HuTongShan/-_-_PLC/SH2024-0302-018/产前文件/SH2024-0302-018电气原件采购.xlsx

版权保护。严令禁止在未获得明确授权的情况下转发和复制本文档，利用及传播其内容。 | 0 |  |  |  |  | 1 |  | 2 |  | 3 |  |  | 4 |  |  | 5 |  | 6 |  |  |  | 7 |  | 8 |  |  | 9
 | 部件汇总表
 |  | 序号 |  | 标识符 |  |  |  |  | 名称 |  | 规格型号 |  |  |  | 技术参数 |  |  |  | 数量 |  | 单位 |  | 品牌 |  | 备注
 |  | 2 |  | F1 |  |  |  |  | IC65N断路器 |  | SE.A9F19440 |  |  |  | 4P D40A |  |  |  | 1 |  | 件 |  | 施耐德 |  | 断路器
 |  | 3 |  | F2 |  |  |  |  | IC65N断路器 |  | SE.A9F19320 |  |  |  | 3P D20A |  |  |  | 1 |  | 件 |  | 施耐德 |  | 断路器
 |  | 4 |  | F3 |  |  |  |  | IC65N断路器 |  | SE.A9F19210 |  |  |  | 2P D10A |  |  |  | 1 |  | 件 |  | 施耐德 |  | 断路器
 |  | 5 |  | F4 |  |  |  |  | IC65N断路器 |  | SE.A9F19206 |  |  |  | 2P D6A |  |  |  | 1 |  | 件 |  | 施耐德 |  | 断路器
 |  | 6 |  | P2 |  |  |  |  | 蜂鸣器 |  | XB2BSB4LC |  |  |  | 24V红/带灯 |  |  |  | 1 |  | 个 |  | 施耐德 |  | 开孔尺寸(mm)Φ22
 |  | 7 |  | P5 |  |  |  |  | 触摸屏 |  | 6AV66480DC113AX0 |  |  |  | SMART 700 IE V4 |  |  |  | 1 |  | 个 |  | 西门子
 |  | 8 |  | PLC-AI |  |  |  |  | 模拟量输出模块 |  | SIE.6ES7288-3AE04-0AA0 |  |  |  |  |  |  |  | 1 |  | 件 |  | 西门子
 |  | 9 |  | PLC-CPU |  |  |  |  | PLC |  | SIE.6ES7288-1SR30-0AA0 |  |  |  |  |  |  |  | 1 |  | 件 |  | 西门子
 |  | 10 |  | PLC-com |  |  |  |  | PLC扩展板 |  | SIE.6ES7288-5CM01-0AA0 |  |  |  |  |  |  |  | 1 |  | 件 |  | 西门子
 |  | 11 |  | XT1 |  |  |  |  | 插座 |  | CHT.AC30 5P10A |  |  |  | 10A |  |  |  | 1 |  | 个 |  | 正泰 |  | 模数化五孔插座
 |  | 12 |  | U1 |  |  |  |  | 变频器 |  | IC863-AVT-0150-403-20 |  |  |  | 11KW |  |  |  | 1 |  | 台 |  | 艾默生 |  | IP21防护等级
 |  | 13 |  | KM1 |  |  |  |  | LC1D接触器 |  | SE.LC1D09M7C |  |  |  | 09A 220VAC |  |  |  | 1 |  | 件 |  | 施耐德
 |  | 14 |  | KM2 |  |  |  |  | LC1D接触器 |  | SE.LC1D18M7C |  |  |  | 18A 220VAC |  |  |  | 1 |  | 件 |  | 施耐德
 |  | 15 |  | Q1 |  |  |  |  | GV2PM电机断路器 |  | SE.GV2PM05C |  |  |  | 0.63-1 A |  |  |  | 1 |  | 件 |  | 施耐德 |  | TeSys GV2P - 3P - 0.63...1 A
 |  | 16 |  | Q2 |  |  |  |  | GV3P电机断路器 |  | SE.GV3P18 |  |  |  | 12-18 A |  |  |  | 1 |  | 件 |  | 施耐德 |  | TeSys GV3P - 3P - 12...18A - EverLink BTR接触
 |  | 17 |  | A3 |  |  |  |  | 交换机 |  | TL-SF1005工业级 |  |  |  | TL-SF1005工业级 |  |  |  | 1 |  | 个 |  | TP-LINK |  | 5个10/100MRJ45口
 |  | 18 |  | P3 |  |  |  |  | 指示灯 |  | XB2BVB3LC |  |  |  | DC24V绿 |  |  |  | 1 |  | 个 |  | 施耐德 |  | 开孔尺寸(mm)Φ22
 |  | 19 |  | P4 |  |  |  |  | 指示灯 |  | XB2BVB4LC |  |  |  | DC24V红 |  |  |  | 1 |  | 个 |  | 施耐德 |  | 开孔尺寸(mm)Φ22
 |  | 20 |  | F5 |  |  |  |  | 急停按钮 |  | XB2BS545C |  |  |  | 红色1NO+1NC |  |  |  | 1 |  | 个 |  | 施耐德 |  | 开孔:Φ22，按钮头:Φ40
 |  | 21 |  | KA1;KA2 |  |  |  |  | 继电器 |  | SE.RXM4LB2BD+RXZE1M4C |  |  |  | DC 24V |  |  |  | 2 |  | 件 SE- |  | RXM RSL继电 |  | 器
 |  | 22 |  | S1;S2 |  |  |  |  | 旋转开关 |  | XB2BD21C |  |  |  | 1NO |  |  |  | 2 |  | 个 |  | 施耐德 |  | 开孔尺寸(mm)Φ22
 |  | 23 |  | S3 |  |  |  |  | 平头复位按钮 |  | XB2BA51C |  |  |  | 黄 1NO |  |  |  | 1 |  | 个 |  | 施耐德 |  | 开孔尺寸(mm)Φ22
 |  | 24 |  | S4 |  |  |  |  | 平头复位按钮 |  | XB2BA31C |  |  |  | 绿 1NO |  |  |  | 1 |  | 个 |  | 施耐德 |  | 开孔尺寸(mm)Φ22
 |  | 25 |  | S5 |  |  |  |  | 平头复位按钮 |  | XB2BA42C |  |  |  | 红 1NC |  |  |  | 1 |  | 个 |  | 施耐德 |  | 开孔尺寸(mm)Φ22
 |  | 26 |  | T1 |  |  |  |  | EDR电源 |  | MW.EDR-75-24 |  |  |  | 3.2A |  |  |  | 1 |  | 个 |  | MW
 | &EAA/16 2
 |  |  |  |  |  |  | 项目名称 SH2024-0302-018 |  |  |  |  | 项目编号 SH2024-0302-018 |  | 冉昆真空科技（浙江）有限公司 |  |  | 部件汇总表 : - MW.EDR-75-24 |  |  |  |  |  |  |  |  | = |  | &EAB
 |  |  |  |  |  |  | SH2024-0302-018电气设计
 |  |  |  |  |  |  |  |  |  |  |  | 图号 |  |  |  |  |  |  |  |  |  |  |  |  |  | + |  | 页 1
修改 |  |  | 日期 |  | 姓名 |  | 创建者 虎存ft |  |  |  |  | 批准人 |  |  |  |  | 日期 2024/3/15 |  |  | 校对 虎存ft |  |  |  |  |  |  |  | 页数 17 从 20
