HuTongShan/-_-_PLC/SH2024-0302-018/产前文件/挂墙孔.dxf

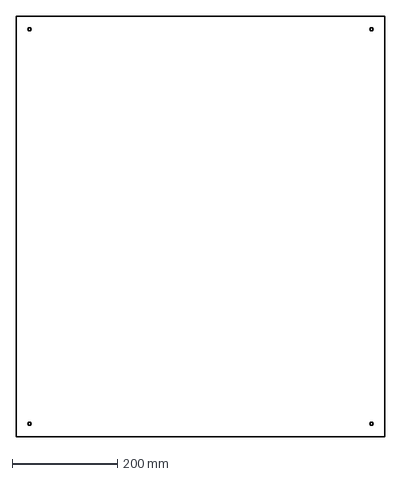
[picture p1: CAD file, 2025-05-08]
SH2024-0302-018/产前文件/挂墙孔.dxf
700.0 x 800.0 mm
