HuTongShan/-_-_PLC/SH2024-0302-018/产前文件/SH2024-0302-018电气原理图.pdf

页数 | 从

## SH2024-0302-018电气设计

校对

SH2024-0302-018

日期 | 日期 | EPL
修改
3 | 6 | 7 | 8 | 9
2021/3/30 | 1
姓名
冉昆真空科技（浙江）有限公司 | &EAA

+

首页 | =
页 | 1
批准人

项目名称

图号

项目编号

创建者 | 虎存山

版权保护。严令禁止在未获得明确授权的情况下转发和复制本文档，利用及传播其内容。

# 冉昆真空科技（浙江）有限公司

项目描述 | SH2024-0302-018电气设计

页数

设计

# 编辑日期：

图号 | SH2024-0302-018

20

# 浙江嘉兴

# 虎存山

地址

# 制造商(公司)

项目名称 | SH2024-0302-018
项目负责人 | 王经理

# 公司/客户

2024/3/15 | 创建者：

# 冉昆真空科技（浙江）有限公司

电话 | +49 (0)2173 - 39 64 - 0

# 审核人：王经理

# 冉昆真空科技（浙江）有限公司

页数

从

日期 | 日期 | 虎存山 1

2024/3/14

冉昆真空科技（浙江）有限公司 | &EAA +

## 目录 : &EAA/1 - &EAB/2.a

=

页

版权保护。严令禁止在未获得明确授权的情况下转发和复制本文档，利用及传播其内容。

页码 | | | | | | 页描述 | | | | | | | | | | | | | | | | | | | | | | | | | | | | | | 编辑者

目录

页类型 | 日期
1 | 标题页/封页 | 首页 | 2021/3/30 | EPL 2 | 目录 | 目录 : &EAA/1 - &EAB/2.a | 2024/3/14 | 虎存山 3 | 安装板布局 | 机柜三视图 | 2024/3/14 | 虎存山 4 | 安装板布局 | 机柜安装板 | 2024/3/14 | 虎存山 5 | 多线原理图 | 主回路 | 2024/3/14 | 虎存山 6 | 多线原理图 | 风扇&插座 | 2024/3/14 | 虎存山 7 | 多线原理图 | 变频器 | 2024/3/14 | 虎存山 8 | 多线原理图 | PLC-CPU | 2024/3/14 | 虎存山 9 | 多线原理图 | PLC-AI/COM | 2024/3/14 | 虎存山
10 | 多线原理图 | 柜内-DI | 2024/3/14 | 虎存山
11 | 多线原理图 | 柜外-DI | 2024/3/14 | 虎存山
12 | 多线原理图 | 柜内-DQ | 2024/3/14 | 虎存山
13 | 多线原理图 | 柜外-DQ | 2024/3/14 | 虎存山
14 | 多线原理图 | 信号处理 | 2024/3/14 | 虎存山
15 | 多线原理图 | AI接线 | 2024/3/14 | 虎存山
16 | 多线原理图 | 通讯界面 | 2024/3/14 | 虎存山
17 | 部件汇总表 | 部件汇总表 : - MW.EDR-75-24 | 2024/3/14 | 虎存山
18 | PLC 地址概览 | | 2024/3/14 | 虎存山
19 | PLC 地址概览 | | 2024/3/14 | 虎存山

700 mm

192 mm

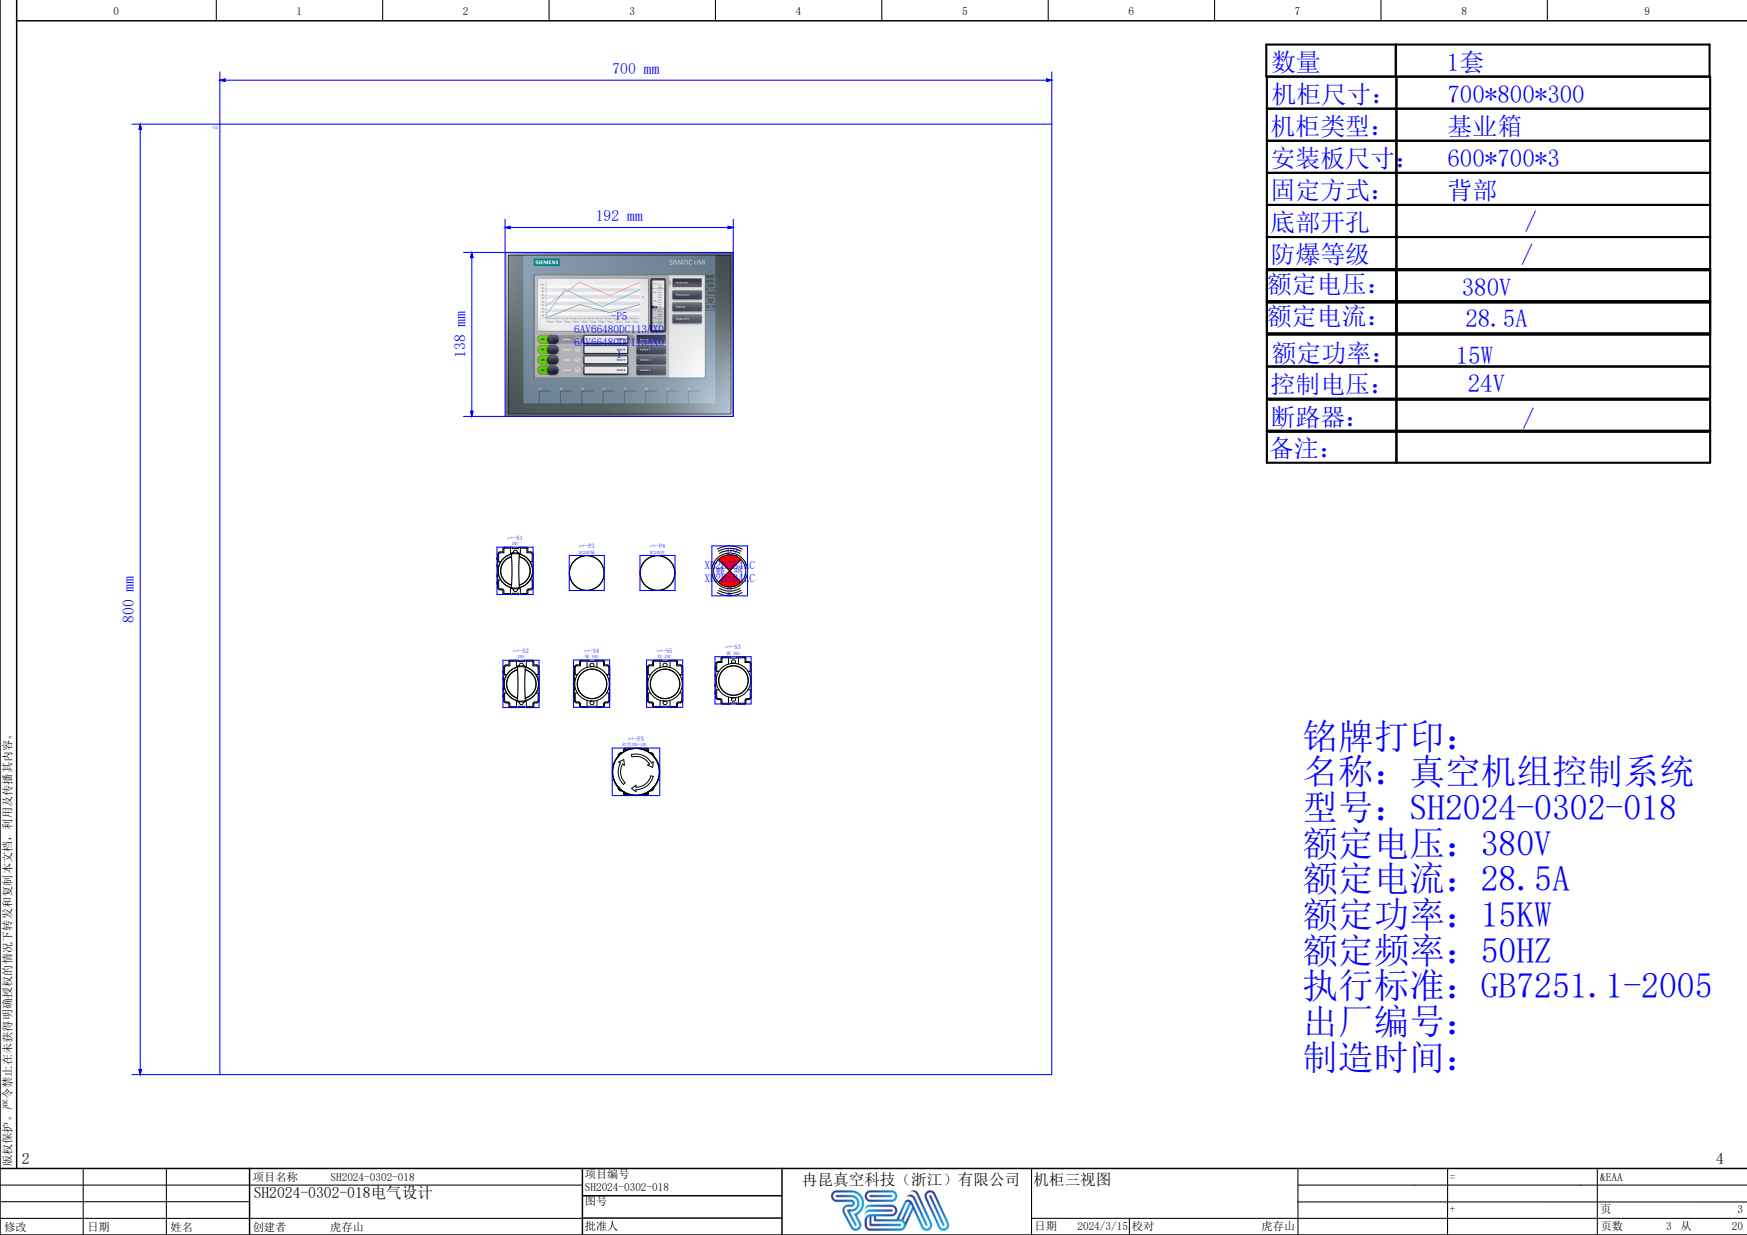
[picture p2: page 3]
虎存山 1; 冉昆真空科技（浙江）有限公司; &EAA +; 机柜三视图; -P2 XB2BSB4LC XB2BSB4LC 2; 铭牌打印： 名称：真空机组控制系统 型号：SH2024-0302-018 额定电压：380V 额定电流：28.5A 额定功率：15KW 额定频率：50HZ 执行标准：GB7251.1-2005 出厂编号： 制造时间：

数量 | 1套
机柜尺寸： | 700*800*300
机柜类型： | 基业箱
安装板尺寸： 600*700*3
固定方式： | 背部
底部开孔 | //
防爆等级
额定电压： | 380V
额定电流： | 28.5A
额定功率： | 15W
控制电压： | 24V
断路器： | /
备注：

版权保护。严令禁止在未获得明确授权的情况下转发和复制本文档，利用及传播其内容。

# AC30 5P10A 9DC 24V =+-KA1

600 mm

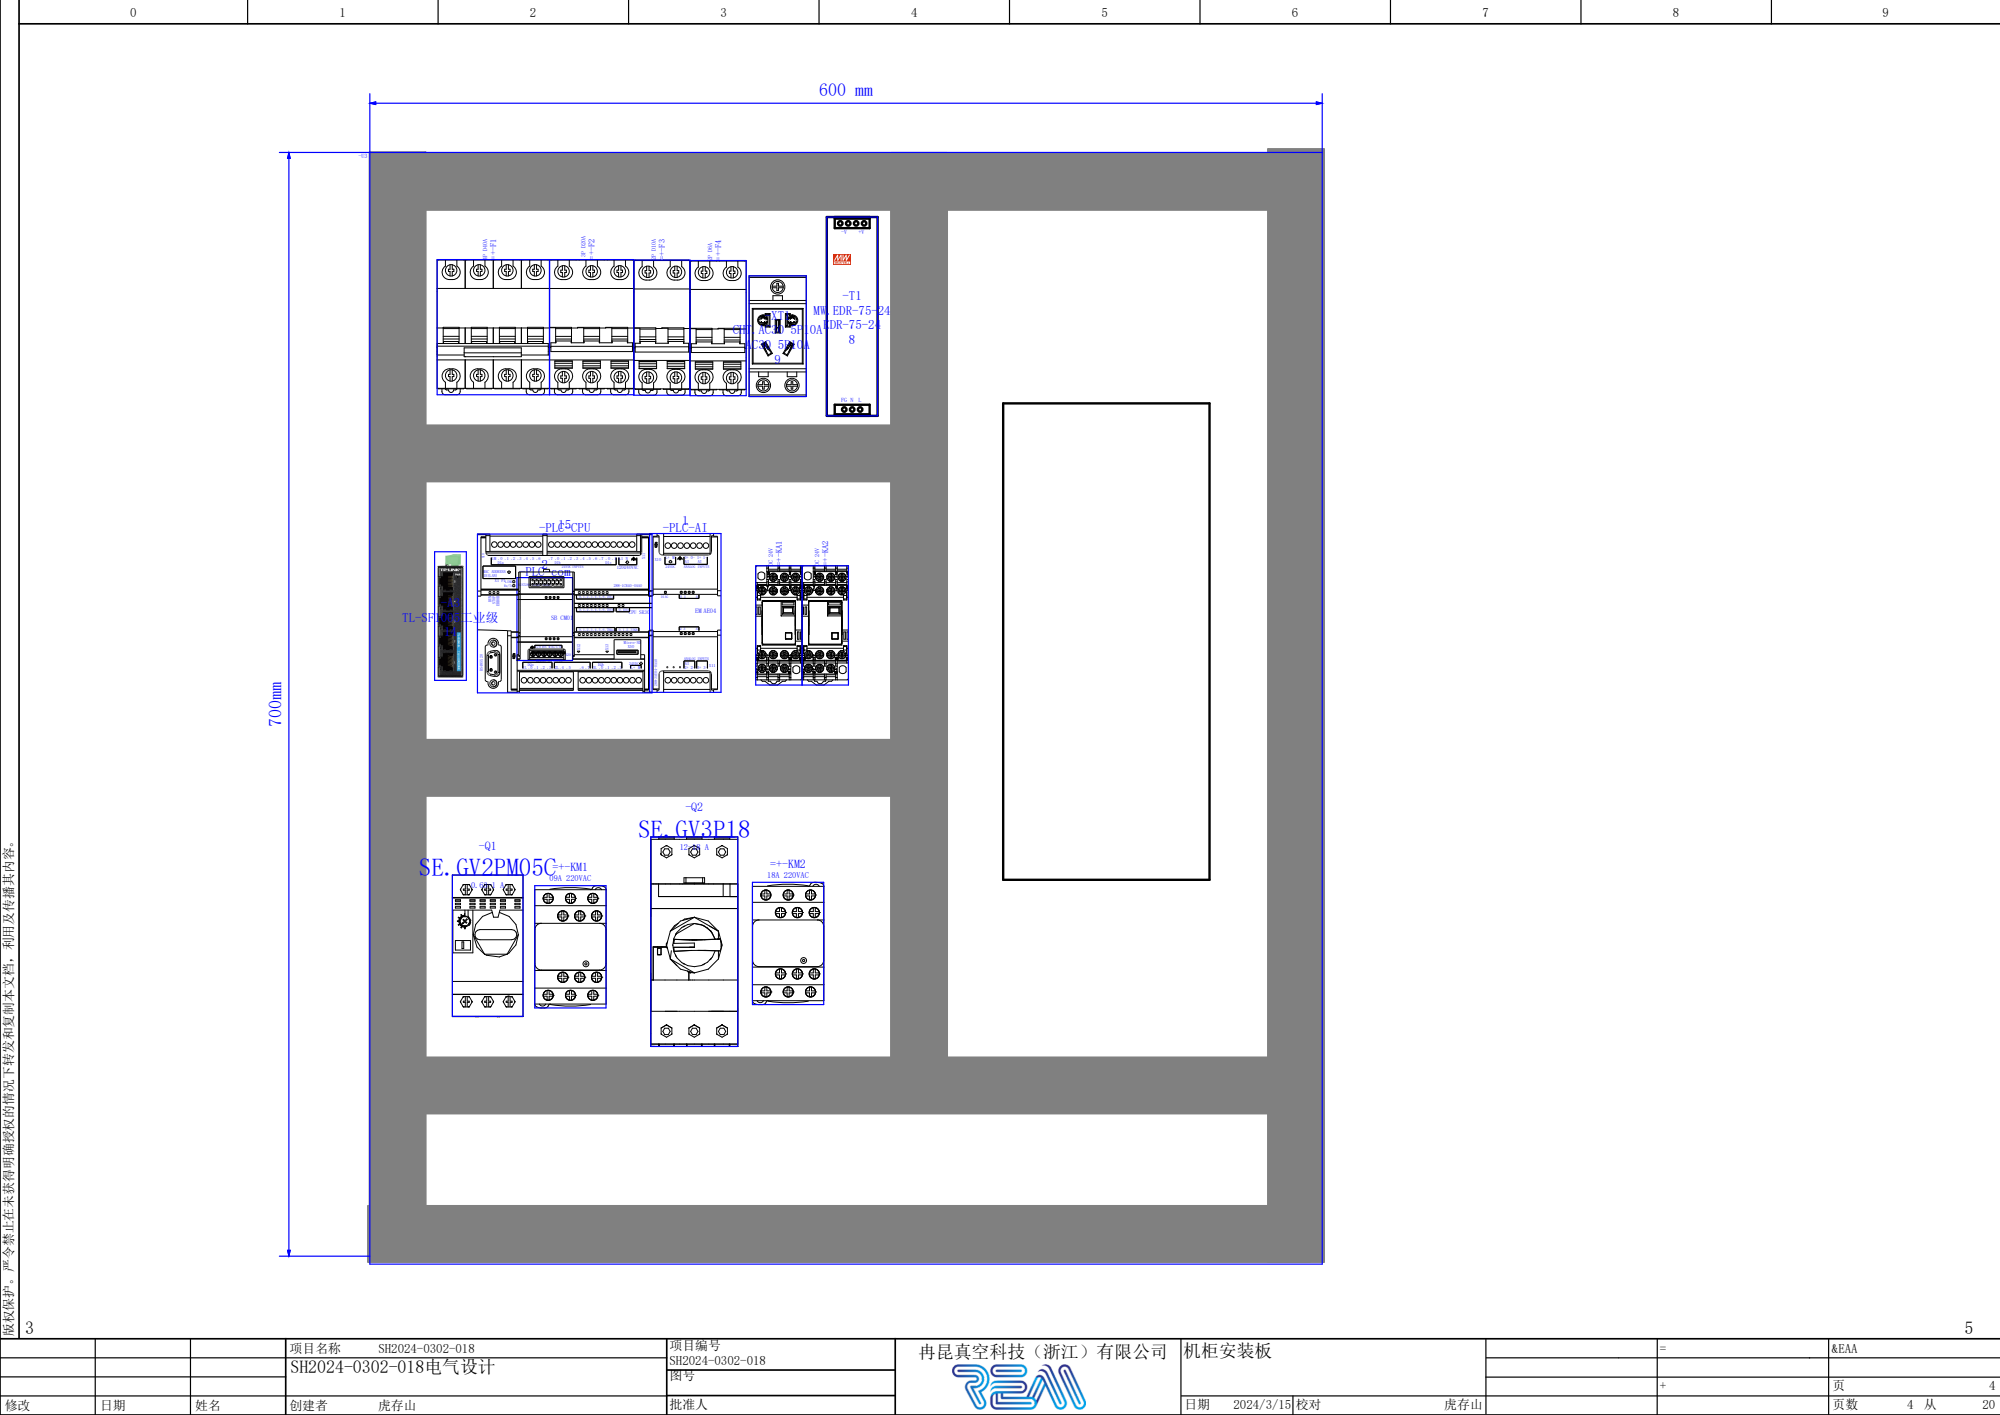
[picture p3: page 4]
虎存山 1; 冉昆真空科技（浙江）有限公司; &EAA +; 机柜安装板; DIAG; ANALOG INPUTS; VDC; ANALOG INPUTS 1 -PLC-AI; Tx/B RTS; 2 -PLC-com; -T1 MW.EDR-75-24 EDR-75-24 8; -XT1 CHT.AC30 5P10A; 09A 220VAC; 18A 220VAC; -A3 TL-SF1005工业级 14; DIa; Micro-SD; STOP ERROR; DQa; CPU SR30; LINK; RELAY OUTPUTS; INPUTS; -240VAC; DIb; .0.1.2.3.4.5.6.7DIb .0.1DIc; .0.1.2.3DQb X12; DQb; 24VDC; .0 .1 DIc; -PLC-CPU 15

MAC ADDRESS
IE(LAN) RUN

版权保护。严令禁止在未获得明确授权的情况下转发和复制本文档，利用及传播其内容。

-F1

L1 /

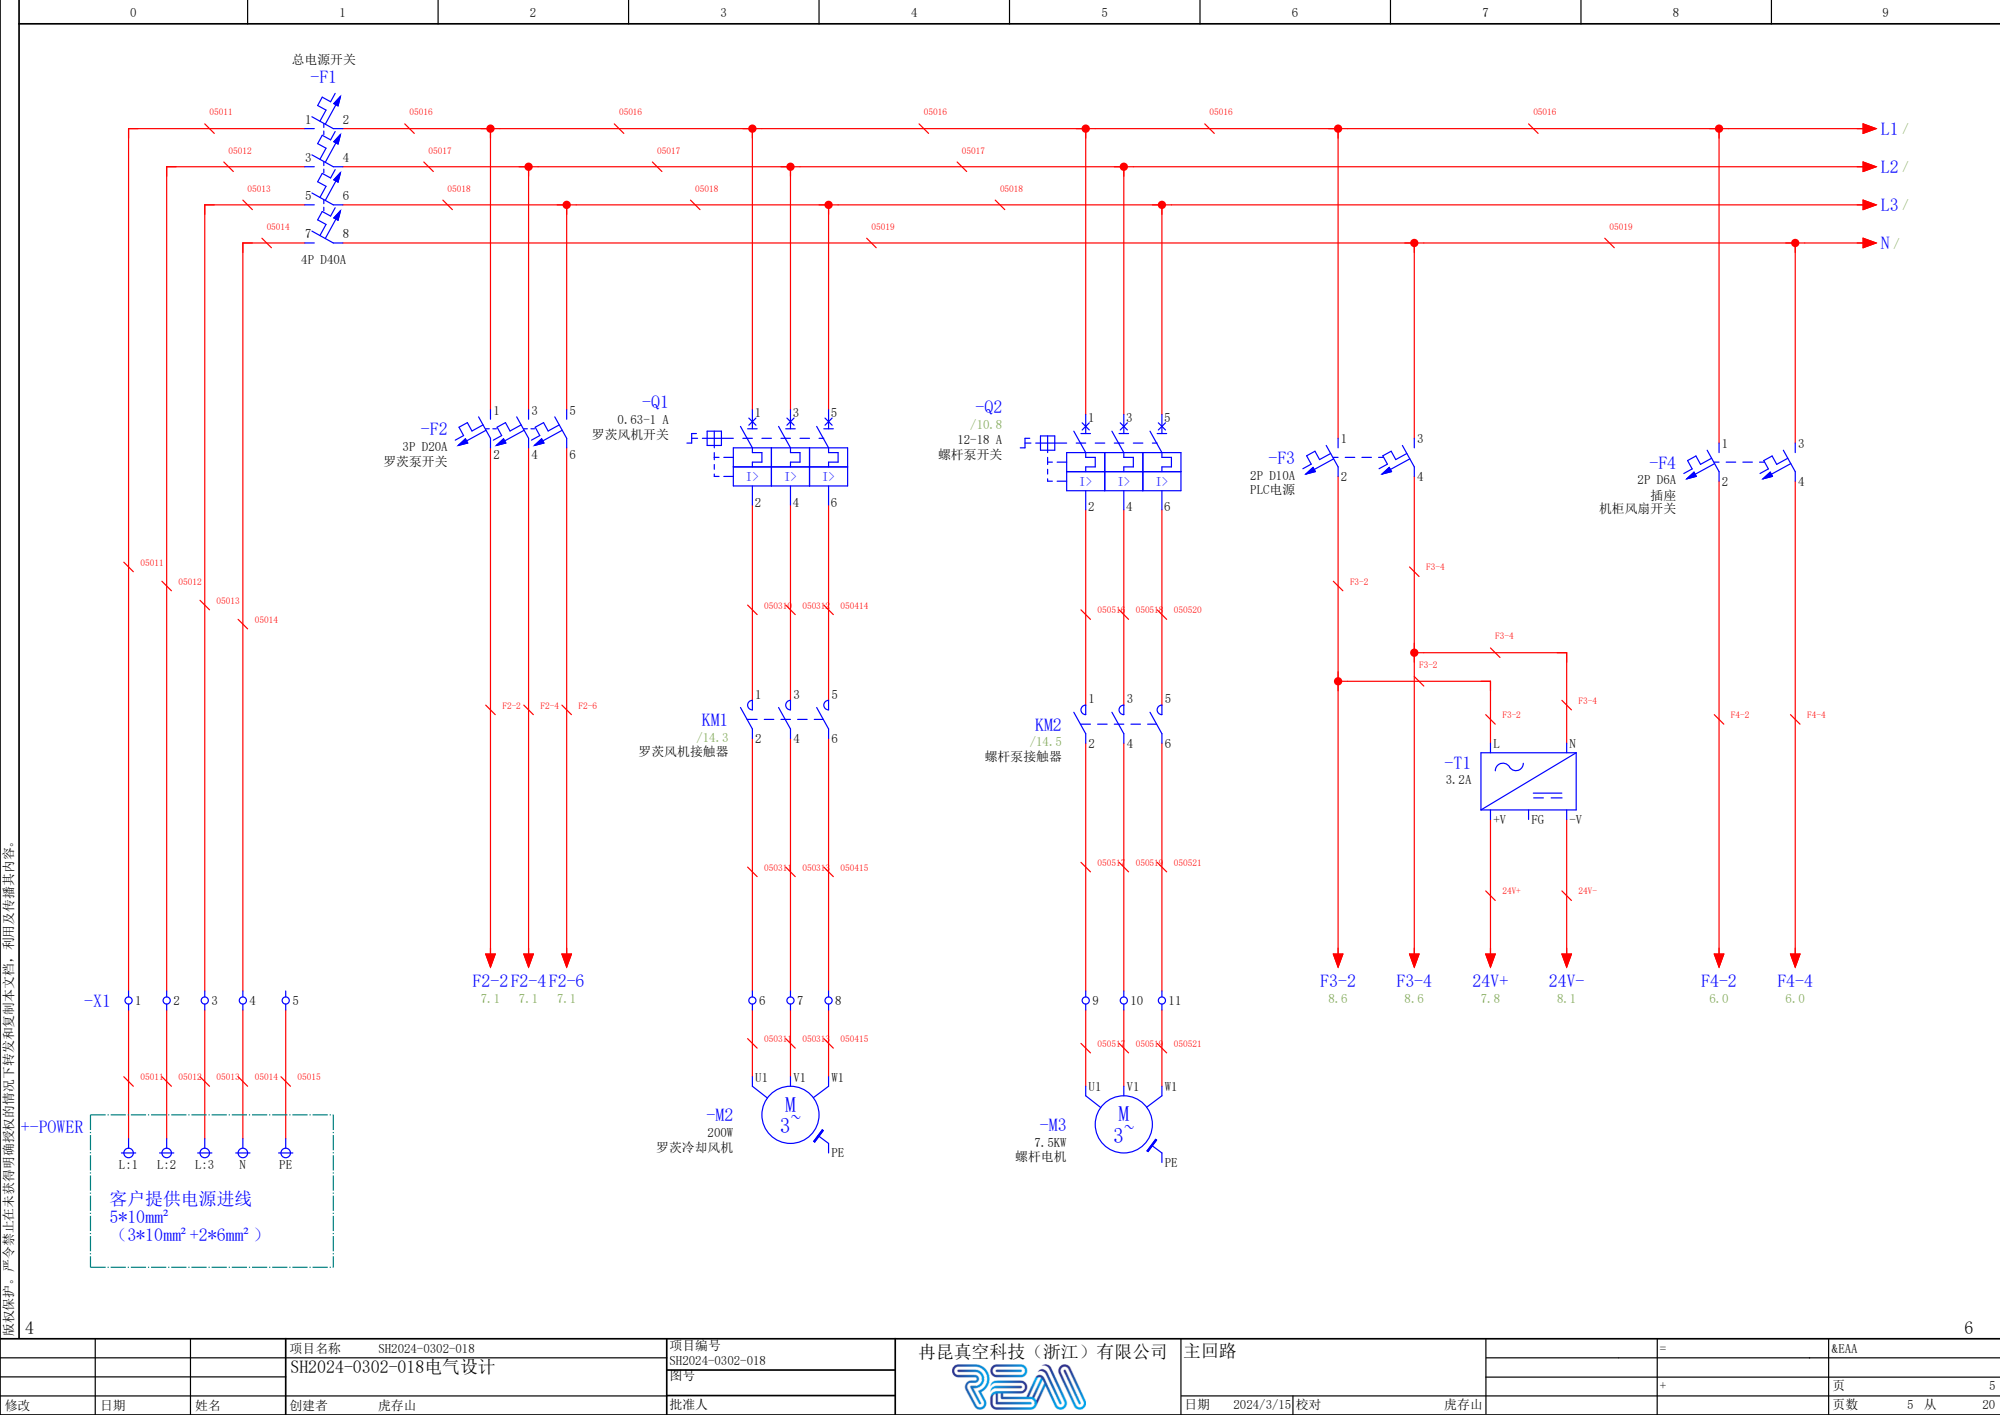
[picture p4: page 5]
虎存山; 主回路; 客户提供电源进线 5*10mm² （3*10mm²+2*6mm²）; 0.63-1 A 罗茨风机开关; /10.8 12-18 A 螺杆泵开关; +-POWER; 200W 罗茨冷却风机; 7.5KW 螺杆电机; 总电源开关; 3P D20A 罗茨泵开关; 2P D10A PLC电源; 2P D6A 插座 机柜风扇开关; /14.3 罗茨风机接触器; /14.5 螺杆泵接触器

版权保护。严令禁止在未获得明确授权的情况下转发和复制本文档，利用及传播其内容。

F4-2 / 5.8

F4-4 / 5.9

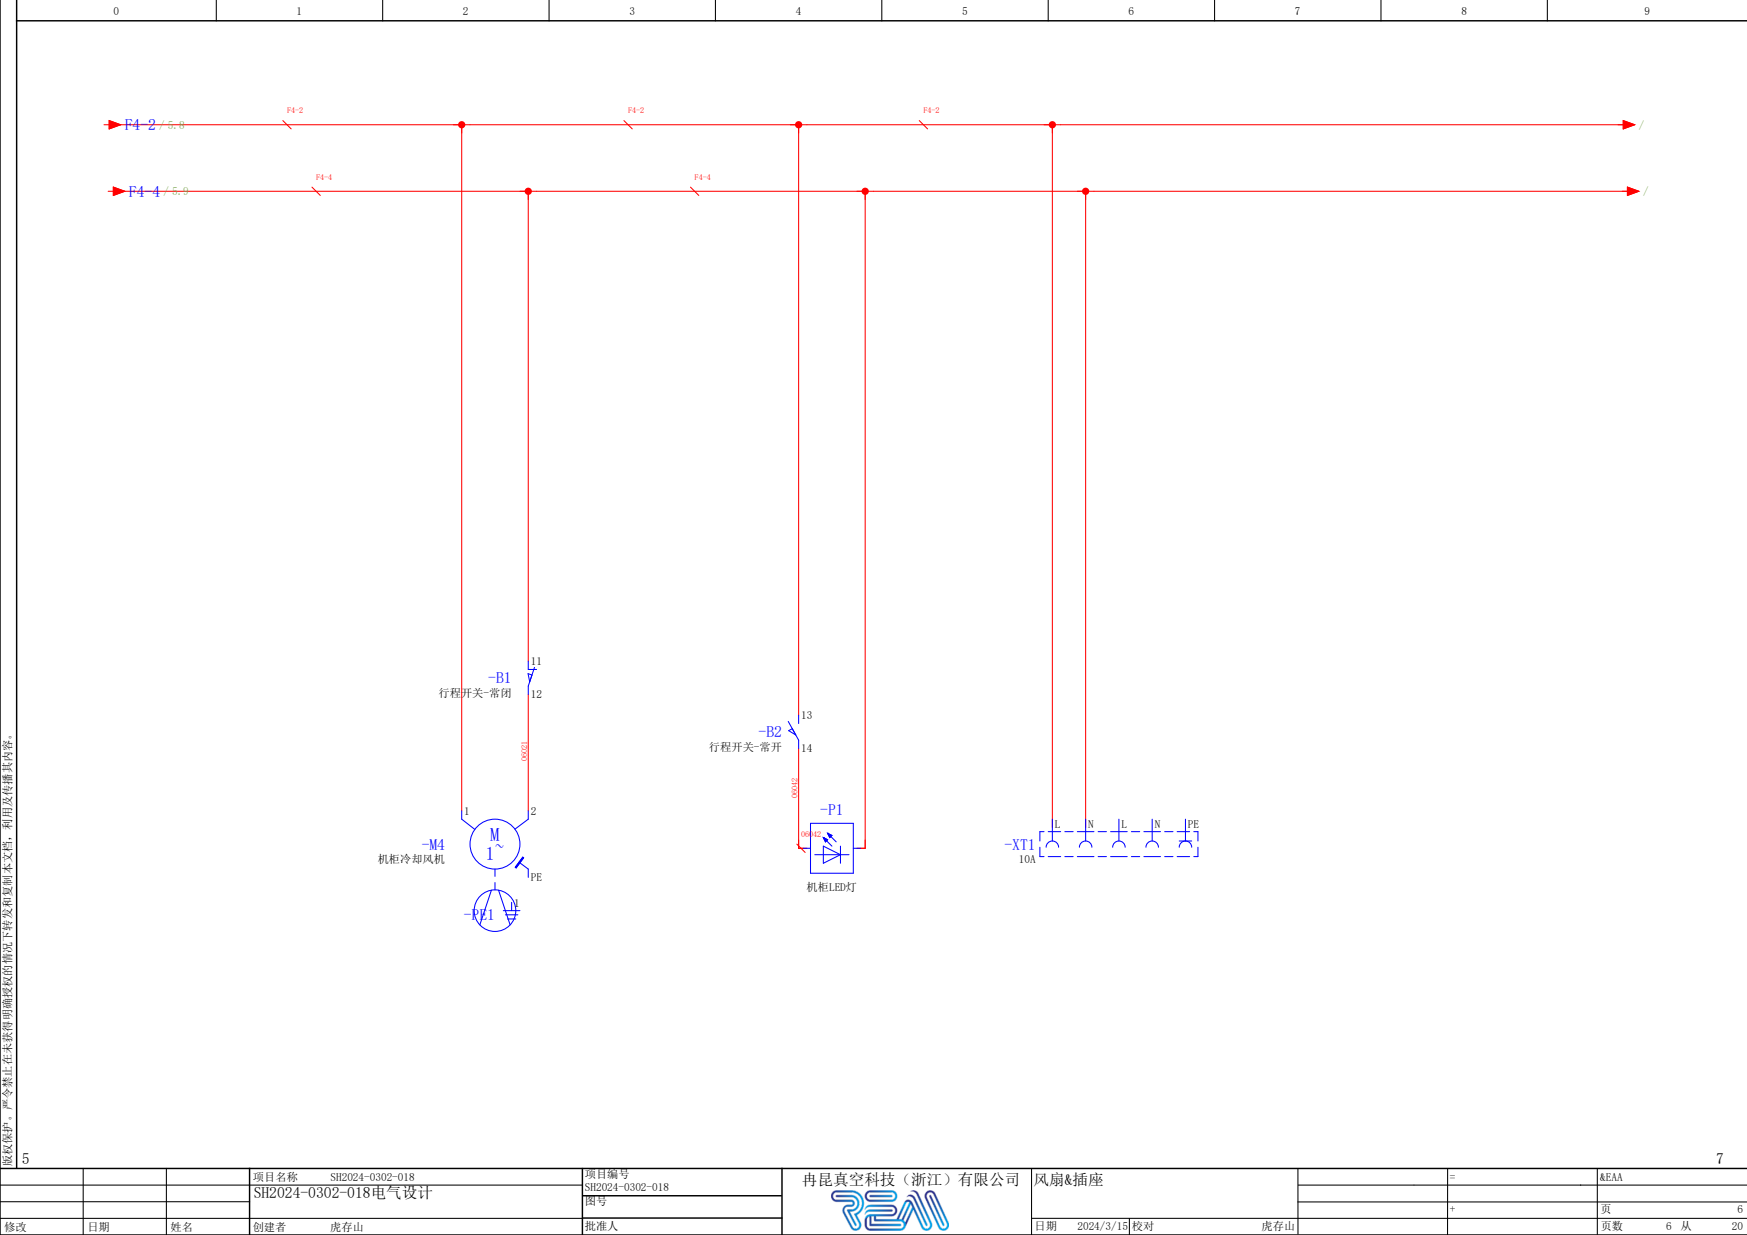
[picture p5: page 6]
机柜冷却风机; 机柜LED灯; 行程开关-常闭; 行程开关-常开

版权保护。严令禁止在未获得明确授权的情况下转发和复制本文档，利用及传播其内容。

-U1

10

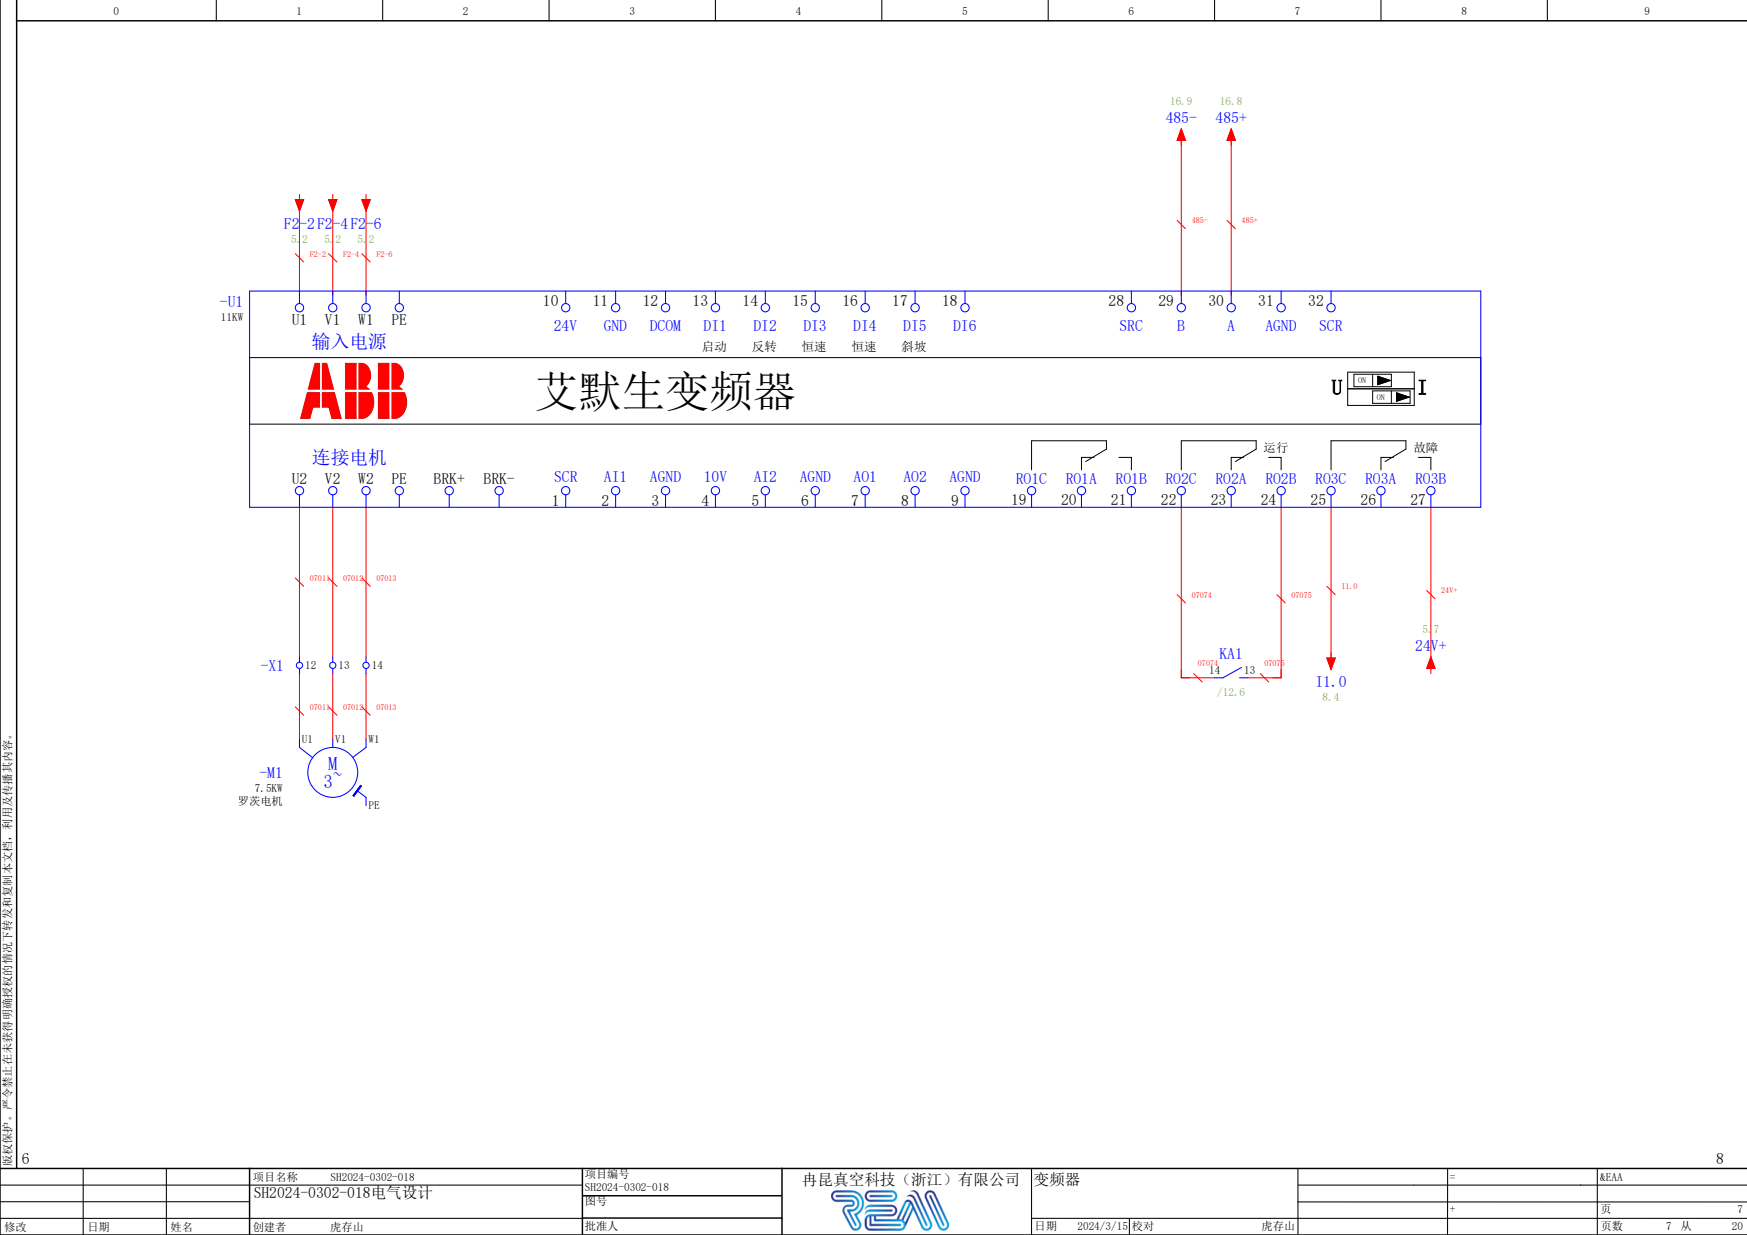
[picture p6: page 7]
变频器; 艾默生变频器; 连接电机; 输入电源; GND; DCOM; BRK+; BRK-; SCR; AGND; SRC; 7.5KW 罗茨电机

版权保护。严令禁止在未获得明确授权的情况下转发和复制本文档，利用及传播其内容。

I0.0
I0.1

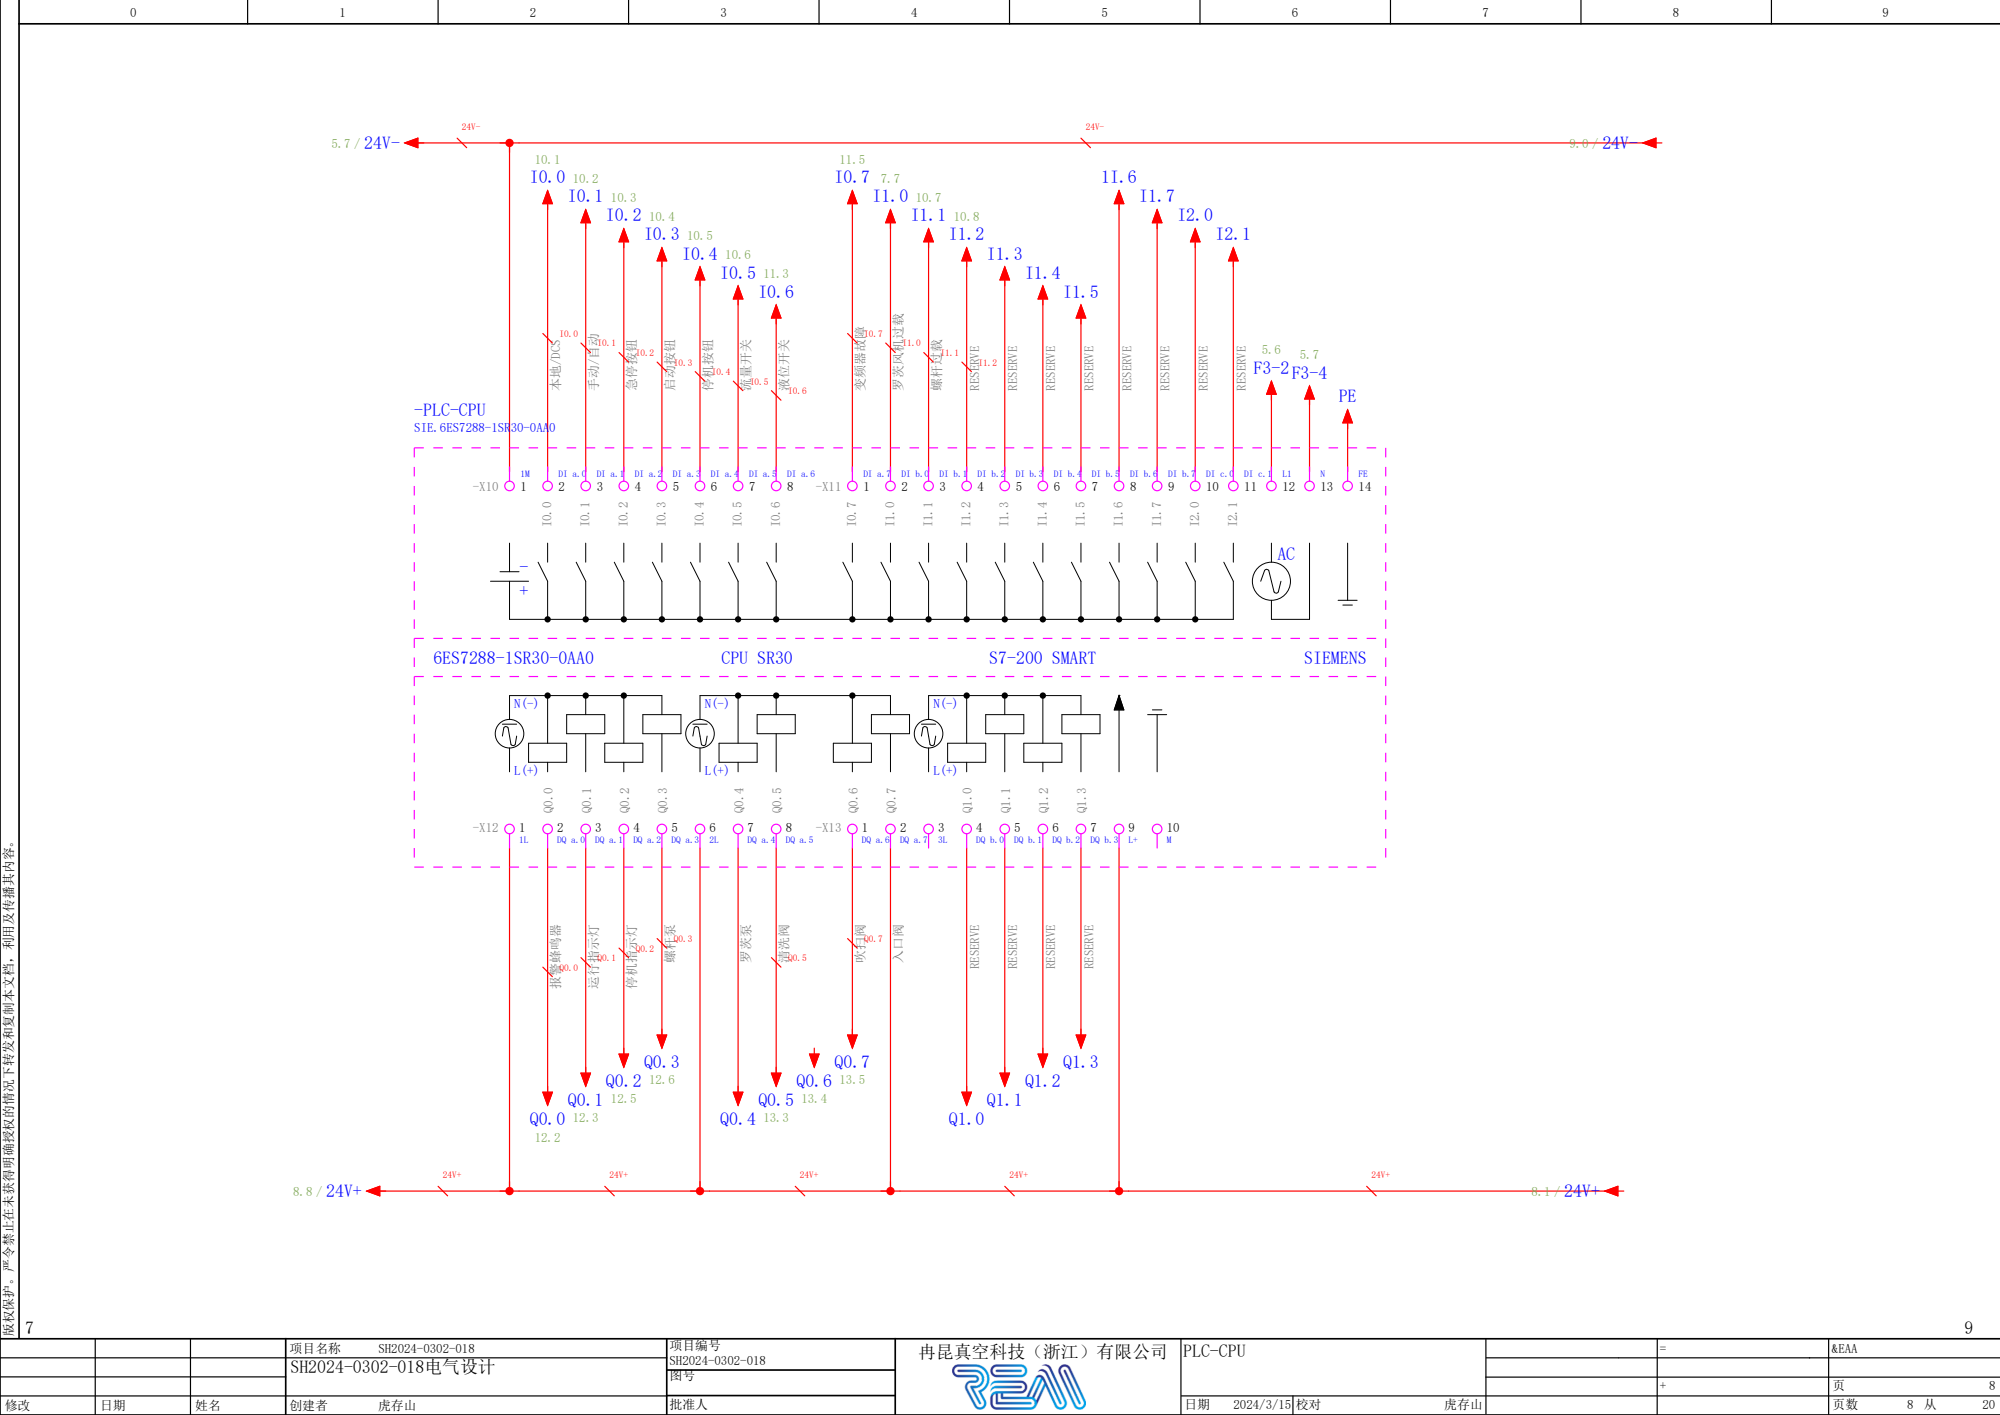
[picture p7: page 8]
PLC-CPU; SIE.6ES7288-1SR30-0AA0; -PLC-CPU; CPU SR30; S7-200 SMART; SIEMENS; I0.0 本地/DCS; I0.2 急停按钮; I0.3 启动按钮; I0.4 停机按钮; I0.5 流量开关; I0.6 液位开关; I0.7 变频器故障; I1.0 罗茨风机过载; I1.1 螺杆过载; I1.2 RESERVE; I1.3 RESERVE; I1.4 RESERVE; I1.5 RESERVE; I1.6 RESERVE; I1.7 RESERVE; I2.0 RESERVE; I2.1 RESERVE; Q0.0 报警蜂鸣器; Q0.1 运行指示灯; Q0.2 停机指示灯; Q0.3 螺杆泵; Q0.5 清洗阀; Q0.4 罗茨泵; Q0.7 入口阀; Q0.6 吹扫阀; Q1.0 RESERVE; Q1.1 RESERVE; Q1.3 RESERVE; Q1.2 RESERVE

版权保护。严令禁止在未获得明确授权的情况下转发和复制本文档，利用及传播其内容。

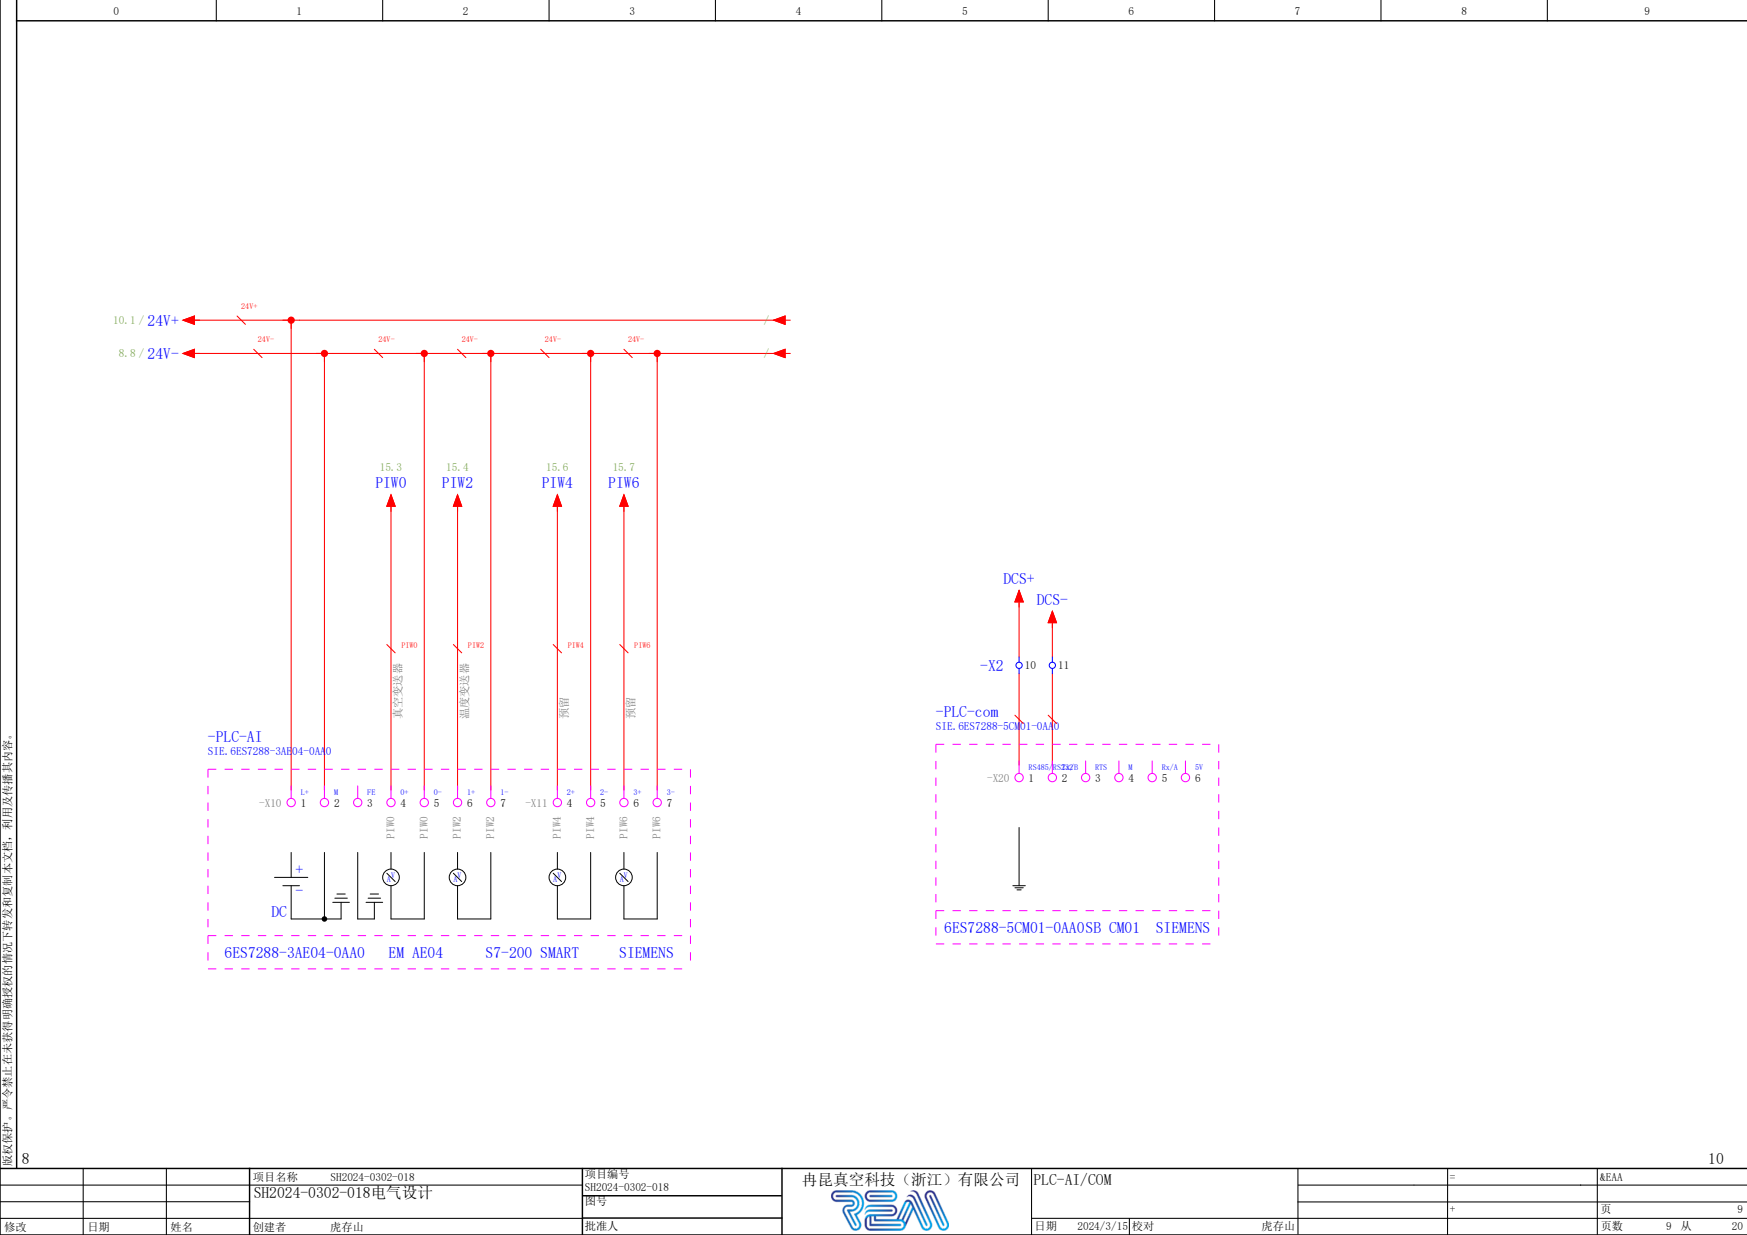
[picture p8: page 9]
PLC-AI/COM; SIE.6ES7288-3AE04-0AA0; -PLC-AI; S7-200 SMART; SIEMENS; PIW0 真空变送器; PIW0; PIW2 温度变送器; PIW2; PIW4 预留; PIW4; PIW6 预留; PIW6; SIE.6ES7288-5CM01-0AA0; -PLC-com; 6ES7288-5CM01-0AA0SB CM01 SIEMENS; RTS; DCS+; DCS-

版权保护。严令禁止在未获得明确授权的情况下转发和复制本文档，利用及传播其内容。

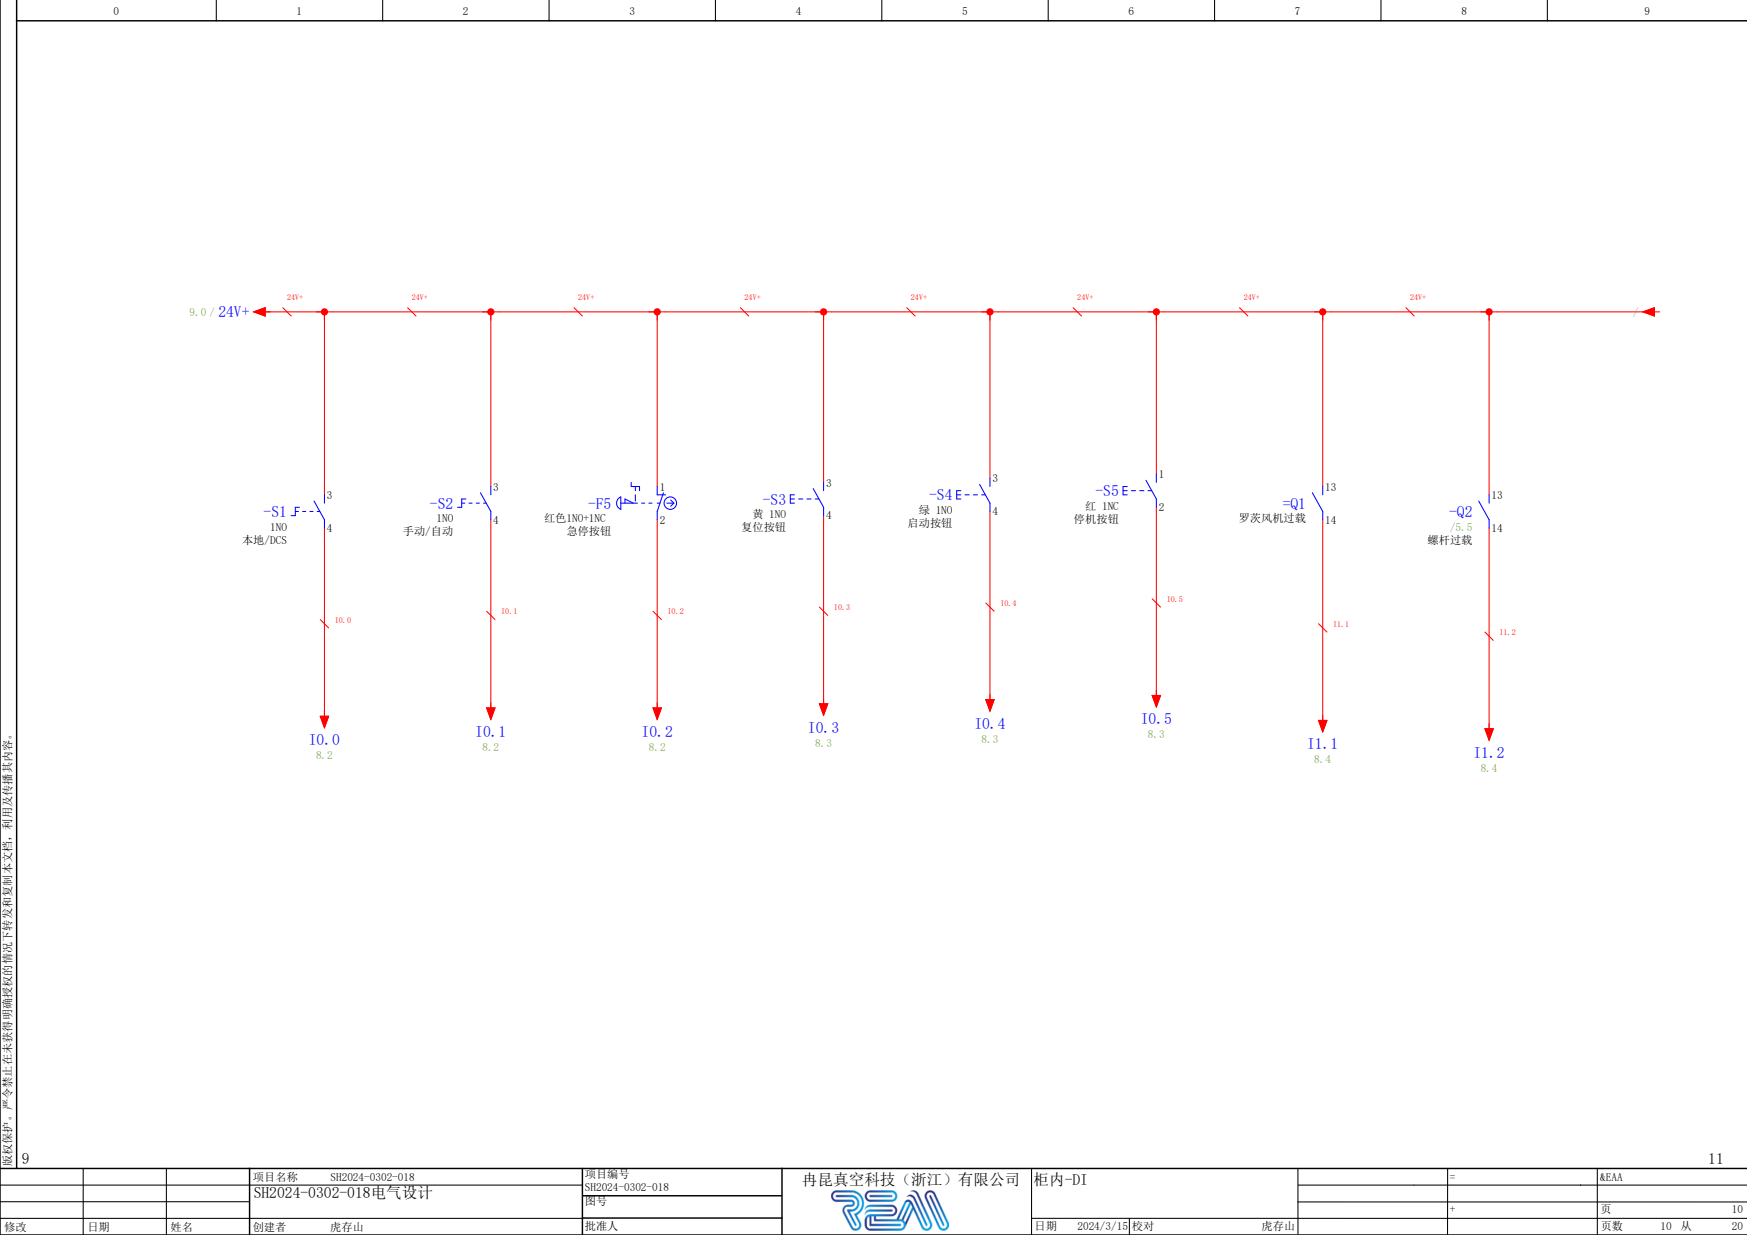
[picture p9: page 10]
1NO 本地/DCS; 红色1NO+1NC 急停按钮; 黄 1NO 复位按钮; 绿 1NO 启动按钮; 红 1NC 停机按钮; 罗茨风机过载; /5.5 螺杆过载

版权保护。严令禁止在未获得明确授权的情况下转发和复制本文档，利用及传播其内容。

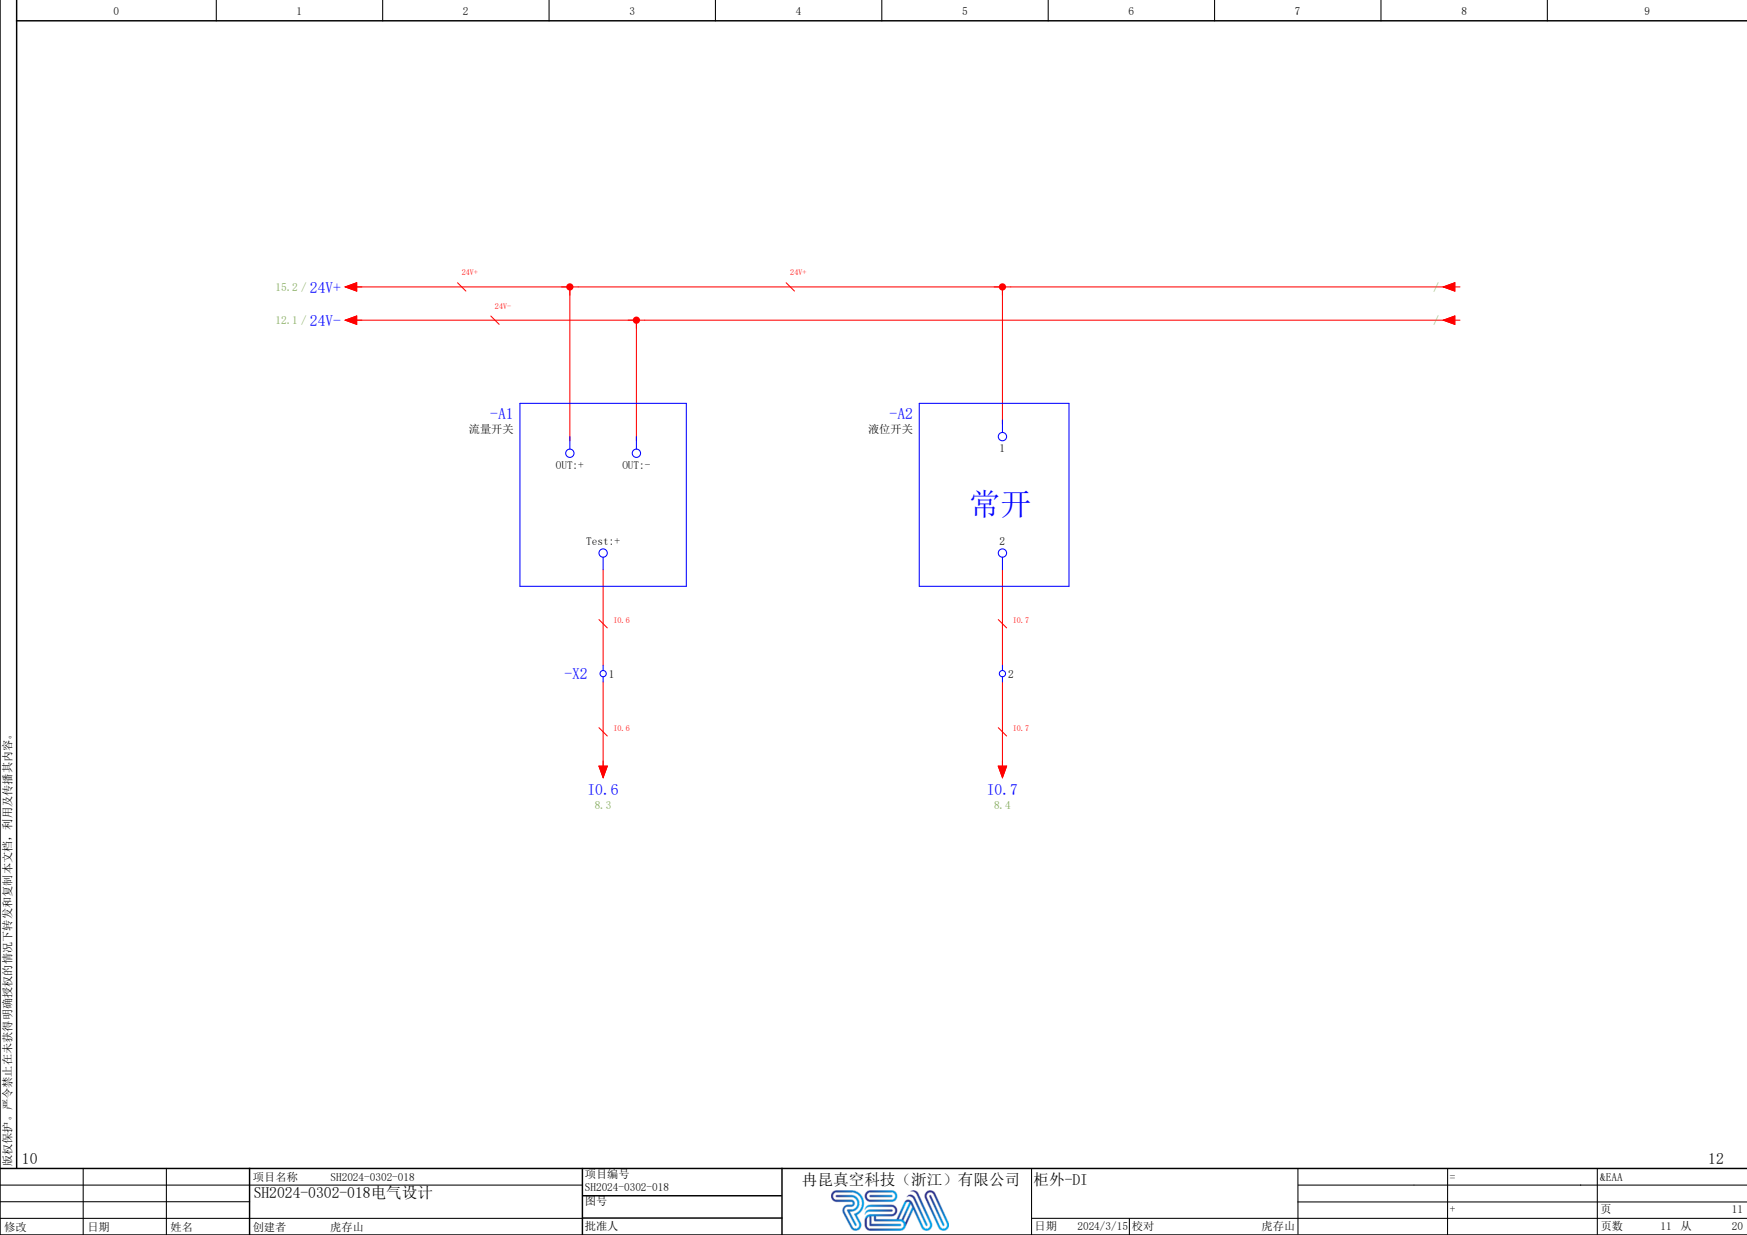
[picture p10: page 11]
流量开关; OUT:+; OUT:-; Test:+; 液位开关

版权保护。严令禁止在未获得明确授权的情况下转发和复制本文档，利用及传播其内容。

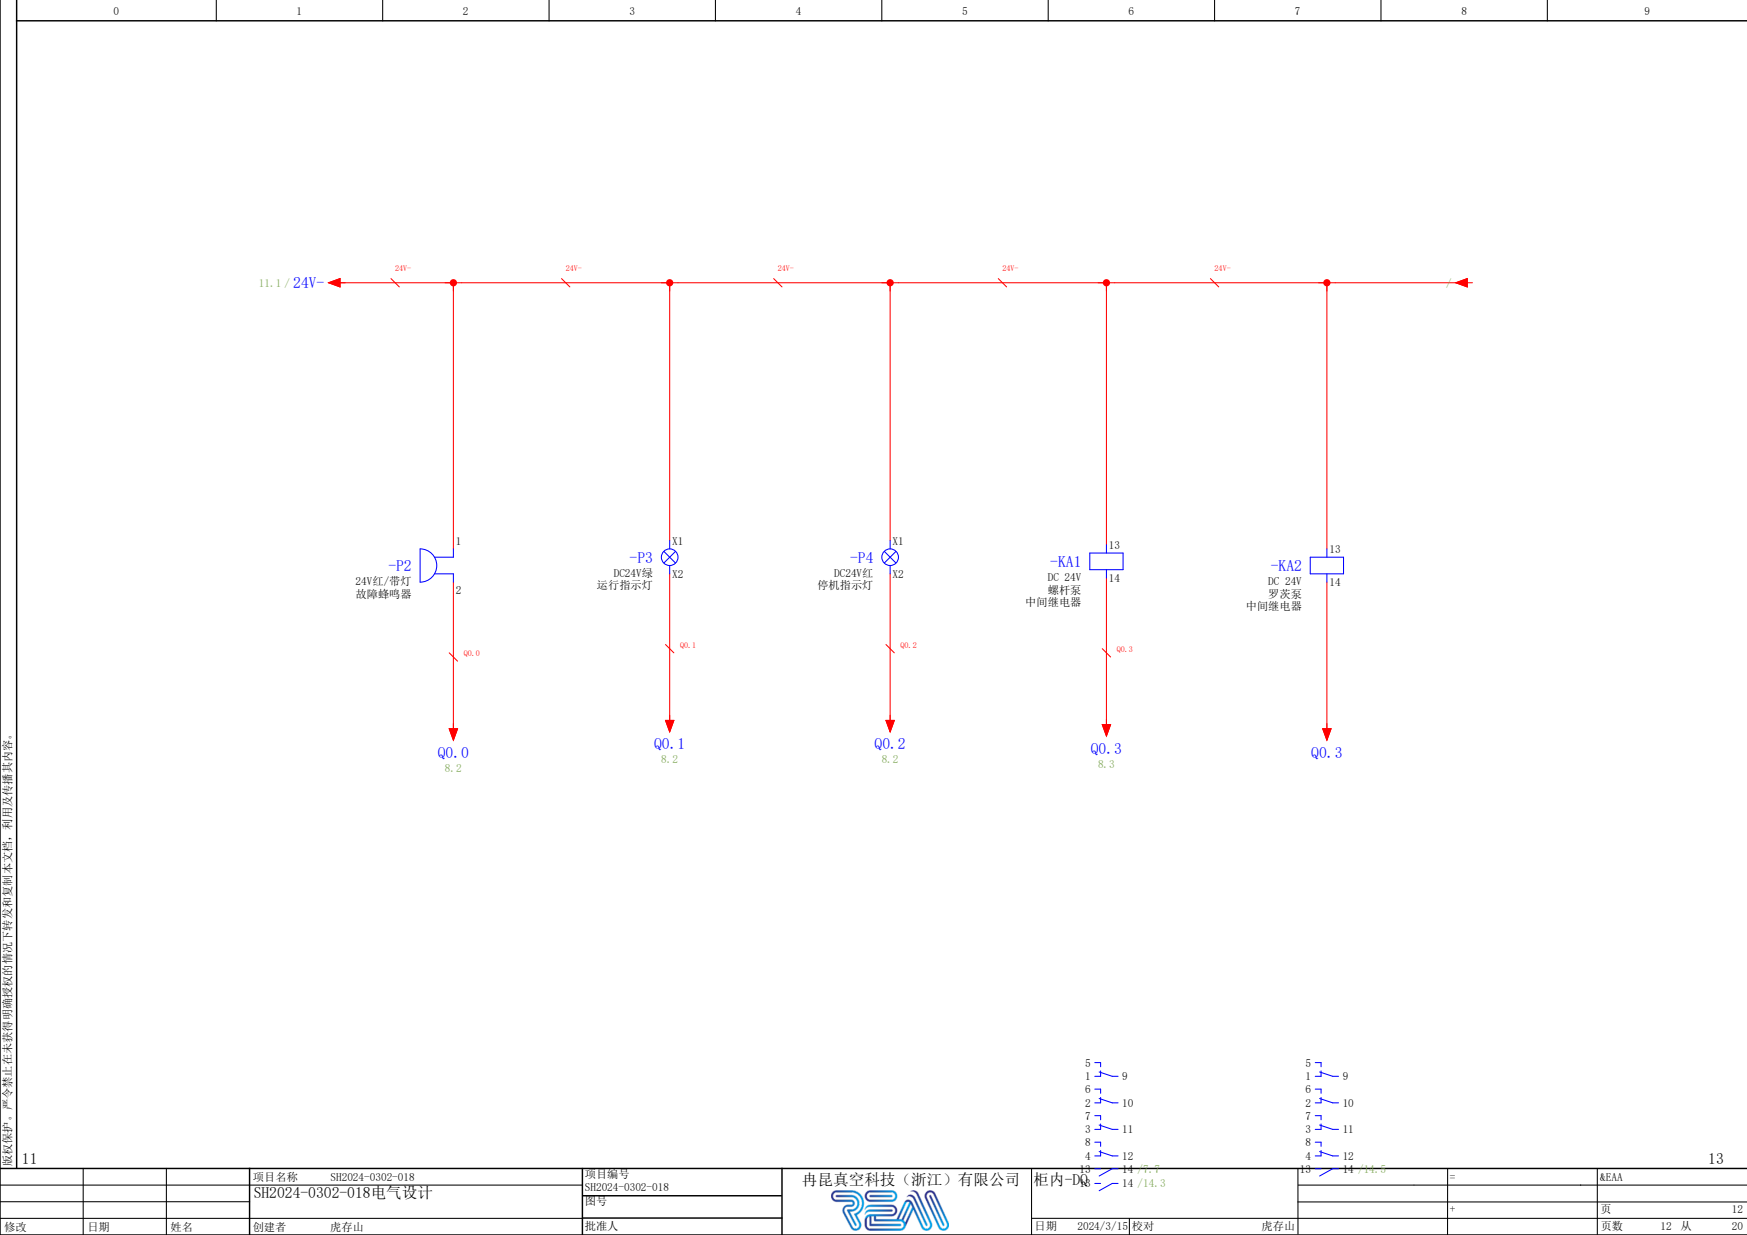
[picture p11: page 12]
24V红/带灯 故障蜂鸣器; DC24V绿 运行指示灯; DC24V红 停机指示灯; DC 24V 螺杆泵 中间继电器; DC 24V 罗茨泵 中间继电器

版权保护。严令禁止在未获得明确授权的情况下转发和复制本文档，利用及传播其内容。

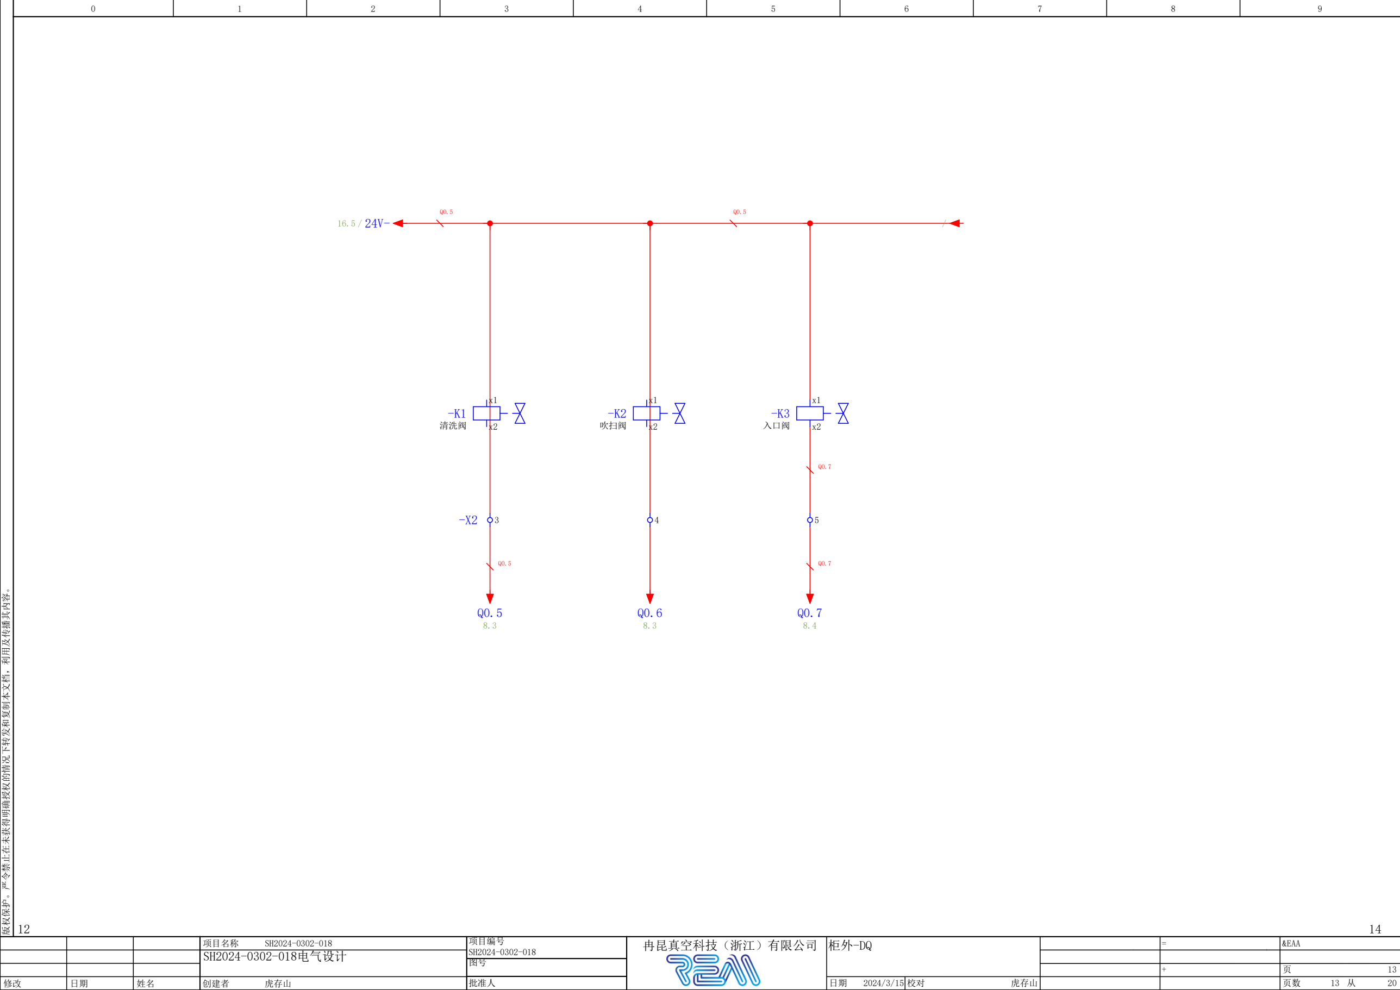
[picture p12: figure]
版权保护。严令禁止在未获得明确授权的情况下转发和复制本文档，利用及传播其内容。; 清洗阀; 吹扫阀; 入口阀

/ F3-2

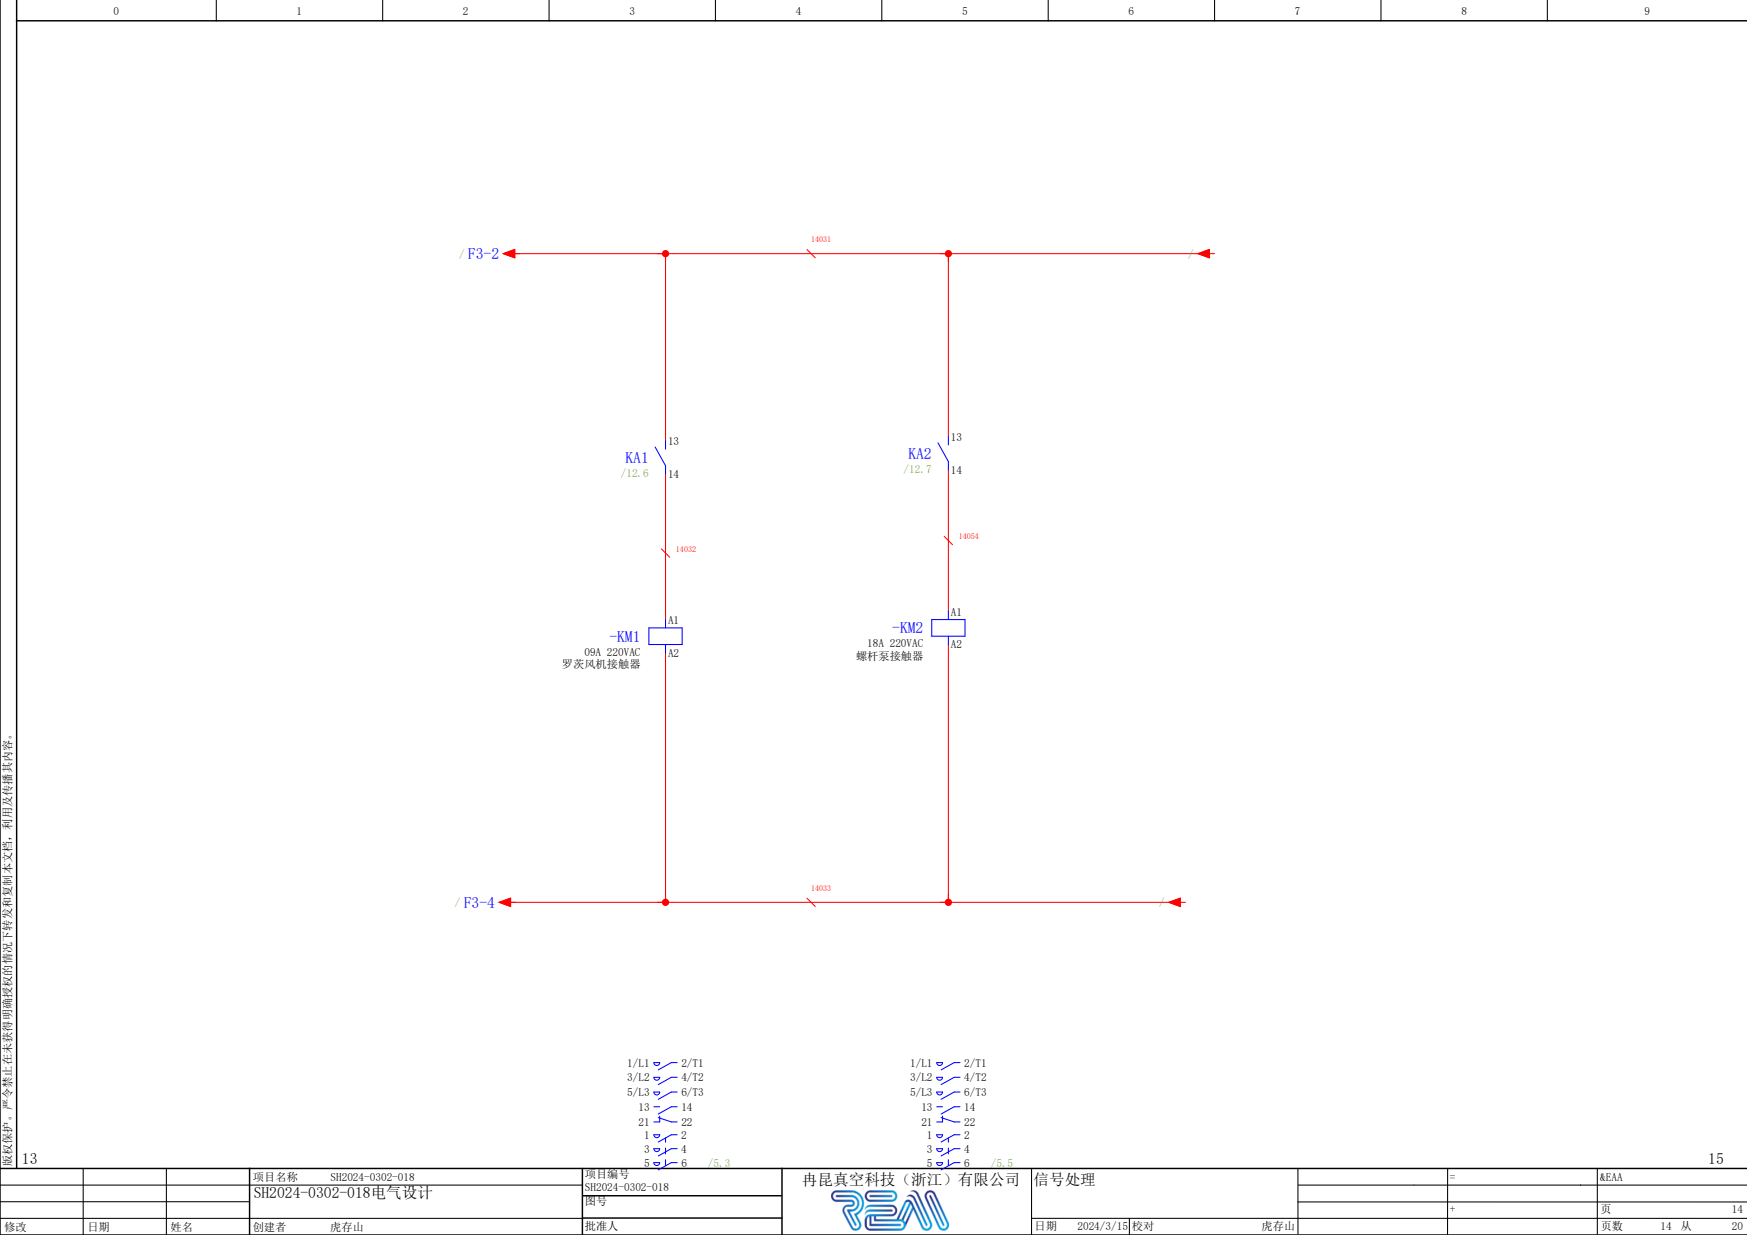
[picture p13: page 14]
信号处理; 09A 220VAC 罗茨风机接触器; 18A 220VAC 螺杆泵接触器

版权保护。严令禁止在未获得明确授权的情况下转发和复制本文档，利用及传播其内容。

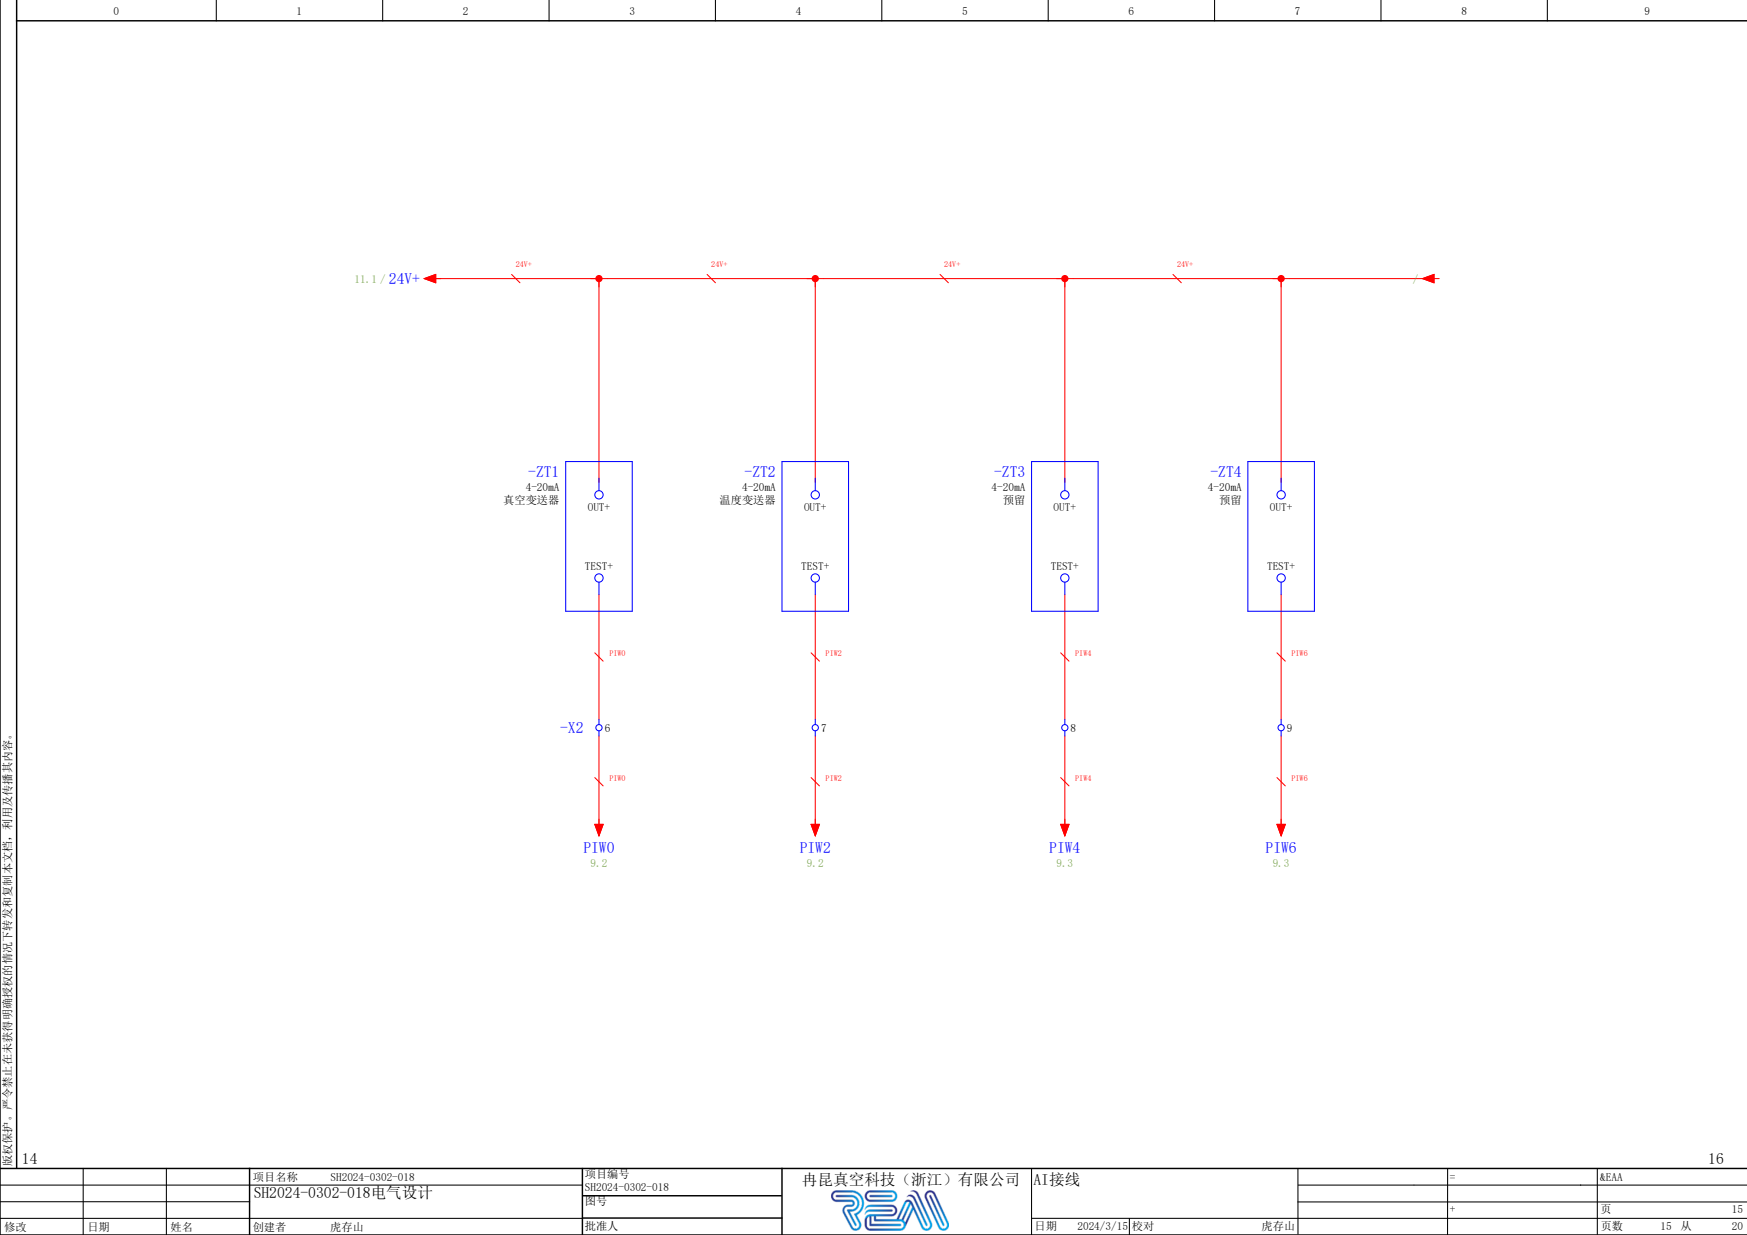
[picture p14: page 15]
AI接线; 真空变送器; OUT+; TEST+; 温度变送器; PIW0; PIW2; PIW4; PIW6

版权保护。严令禁止在未获得明确授权的情况下转发和复制本文档，利用及传播其内容。

# 西门子

# SMART 700 IE V4

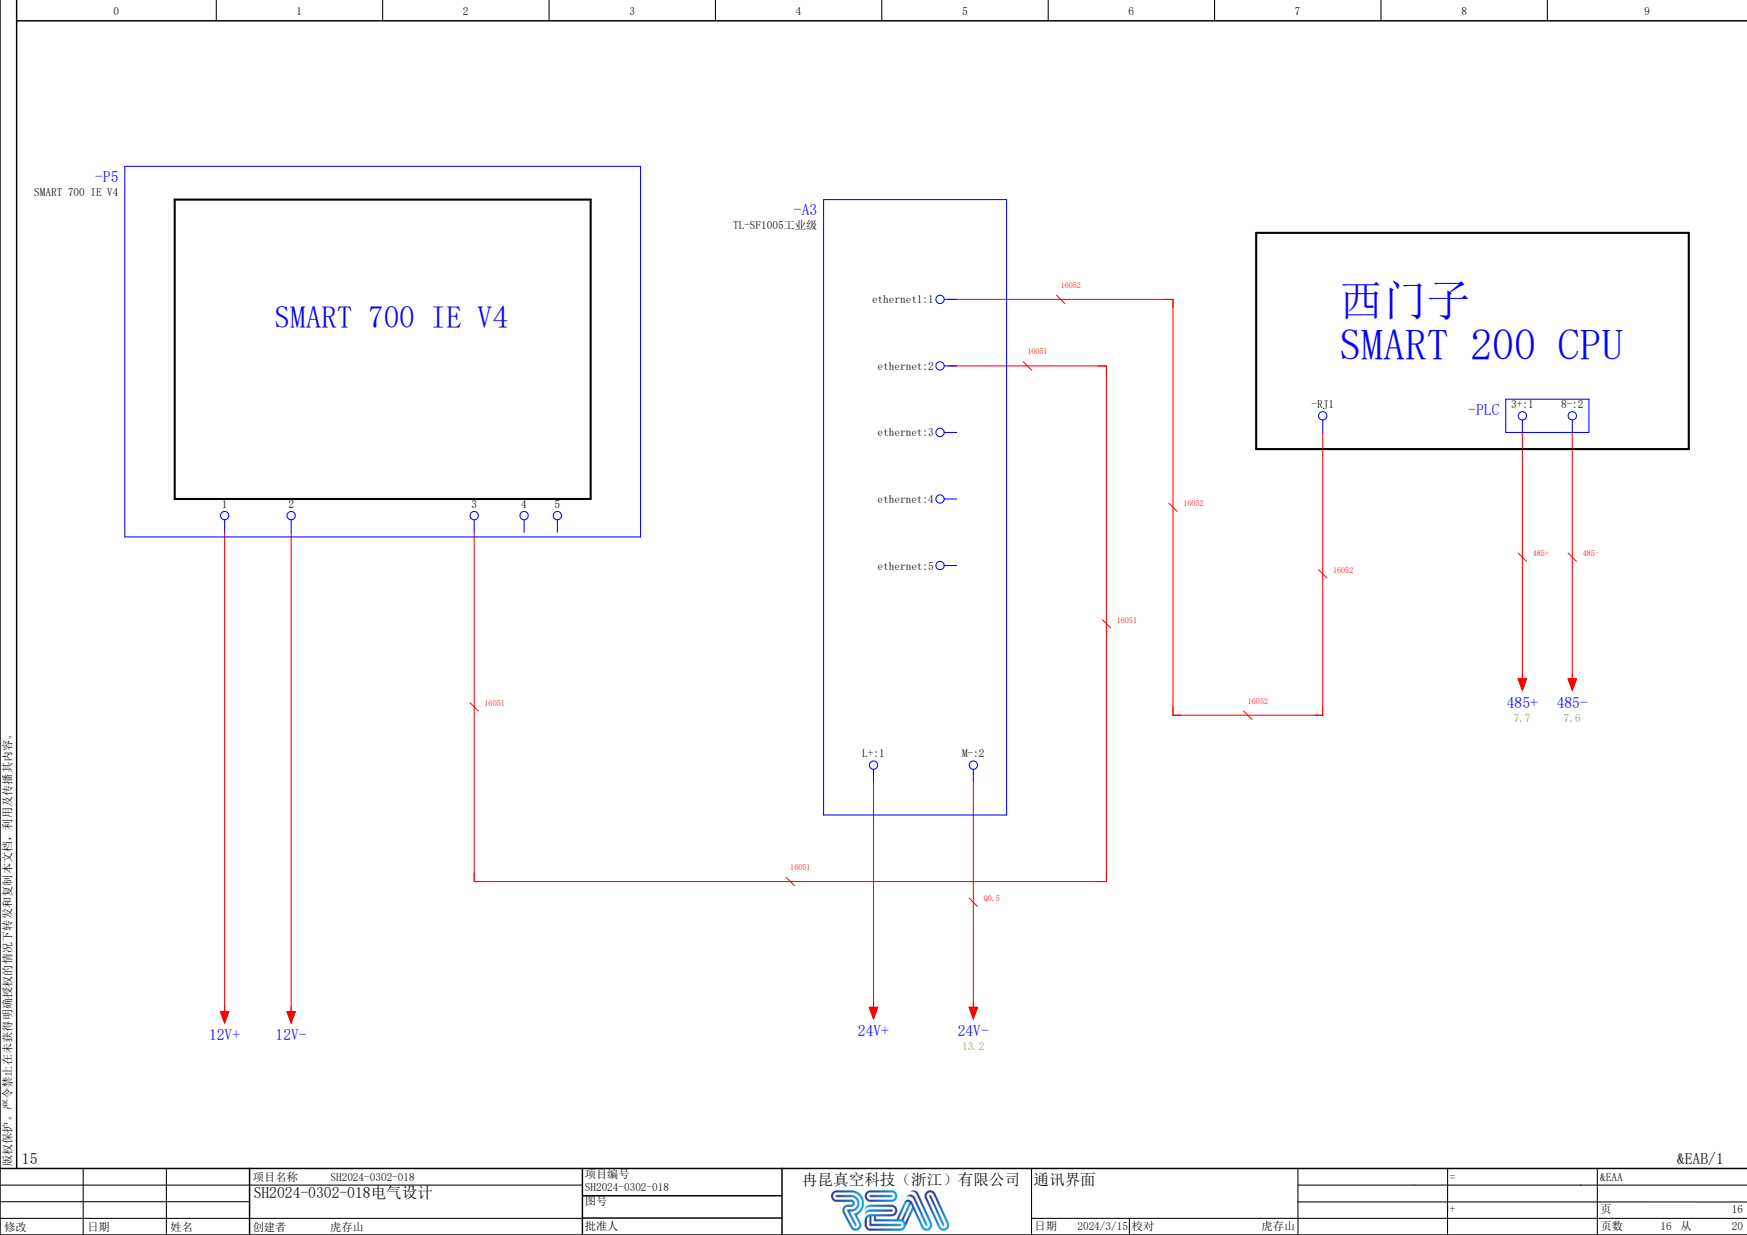
[picture p15: page 16]
&EAB/1; 通讯界面; SMART 200 CPU; -PLC; TL-SF1005工业级; ethernet1:1; ethernet:2; ethernet:3; ethernet:4; ethernet:5; SMART 700 IE V4

版权保护。严令禁止在未获得明确授权的情况下转发和复制本文档，利用及传播其内容。

## &EAA/16

冉昆真空科技（浙江）有限公司 | &EAB
部件汇总表 : - MW.EDR-75-24 | =

版权保护。严令禁止在未获得明确授权的情况下转发和复制本文档，利用及传播其内容。

# 部件汇总表

序号 | 标识符 | 名称 | 规格型号 | 技术参数 | 数量 | 单位 | 品牌 | 备注
1 | A1;A2;B1;B2;K1...K3;M1... M4;P1;PLC;U2;U3;ZT1...ZT4 | | | | 0
2 | F1 | IC65N断路器 | SE.A9F19440 | 4P D40A | 1 | 件 | 施耐德 | 断路器
3 | F2 | IC65N断路器 | SE.A9F19320 | 3P D20A | 1 | 件 | 施耐德 | 断路器
4 | F3 | IC65N断路器 | SE.A9F19210 | 2P D10A | 1 | 件 | 施耐德 | 断路器
5 | F4 | IC65N断路器 | SE.A9F19206 | 2P D6A | 1 | 件 | 施耐德 | 断路器
6 | P2 | 蜂鸣器 | XB2BSB4LC | 24V红/带灯 | 1 | 个 | 施耐德 | 开孔尺寸(mm)Φ22
7 | P5 | 触摸屏 | 6AV66480DC113AX0 | SMART 700 IE V4 | 1 | 个 | 西门子
8 | PLC-AI | 模拟量输出模块 | SIE.6ES7288-3AE04-0AA0 | | 1 | 件 | 西门子
9 | PLC-CPU | PLC | SIE.6ES7288-1SR30-0AA0 | | 1 | 件 | 西门子
10 | PLC-com | PLC扩展板 | SIE.6ES7288-5CM01-0AA0 | | 1 | 件 | 西门子
11 | XT1 | 插座 | CHT.AC30 5P10A | 10A | 1 | 个 | 正泰 | 模数化五孔插座
12 | U1 | 变频器 | ACS510-01-025A-4 | 11KW | 1 | 台 | ABB | IP21防护等级
13 | KM1 | LC1D接触器 | SE.LC1D09M7C | 09A 220VAC | 1 | 件 | 施耐德
14 | KM2 | LC1D接触器 | SE.LC1D18M7C | 18A 220VAC | 1 | 件 | 施耐德
15 | Q1 | GV2PM电机断路器 | SE.GV2PM05C | 0.63-1 A | 1 | 件 | 施耐德 | TeSys GV2P - 3P - 0.63...1 A
16 | Q2 | GV3P电机断路器 | SE.GV3P18 | 12-18 A | 1 | 件 | 施耐德 | TeSys GV3P - 3P - 12...18A -EverLink BTR接触
17 | A3 | 交换机 | TL-SF1005工业级 | TL-SF1005工业级 | 1 | 个 | TP-LINK | 5个10/100MRJ45口
18 | P3 | 指示灯 | XB2BVB3LC | DC24V绿 | 1 | 个 | 施耐德 | 开孔尺寸(mm)Φ22
19 | P4 | 指示灯 | XB2BVB4LC | DC24V红 | 1 | 个 | 施耐德 | 开孔尺寸(mm)Φ22
20 | F5 | 急停按钮 | XB2BS545C | 红色1NO+1NC | 1 | 个 | 施耐德 | 开孔:Φ22，按钮头:Φ40
21 | KA1;KA2 | 继电器 | SE.RXM4LB2BD+RXZE1M4C | DC 24V | 2 | 件 SE-RXM RSL继电器
22 | S1;S2 | 旋转开关 | XB2BD21C | 1NO | 2 | 个 | 施耐德 | 开孔尺寸(mm)Φ22
23 | S3 | 平头复位按钮 | XB2BA51C | 黄 1NO | 1 | 个 | 施耐德 | 开孔尺寸(mm)Φ22
24 | S4 | 平头复位按钮 | XB2BA31C | 绿 1NO | 1 | 个 | 施耐德 | 开孔尺寸(mm)Φ22
25 | S5 | 平头复位按钮 | XB2BA42C | 红 1NC | 1 | 个 | 施耐德 | 开孔尺寸(mm)Φ22
26 | T1 | EDR电源 | MW.EDR-75-24 | 3.2A | 1 | 个 | MW

2.a
冉昆真空科技（浙江）有限公司 | &EAB

=

版权保护。严令禁止在未获得明确授权的情况下转发和复制本文档，利用及传播其内容。

PLC 地址概览 | F48_001
CPU (间接的) | PLC 地址 | 数据类型 | 符号地址(自动) | 功能文本(自动) | 方向 | 规划对象名称
| | | | | 未定义
| | | | | 未定义
| | | | | 未定义
| | | | | 未定义
| I0.0 | BOOL | | 本地/DCS | 输入端
| I0.1 | BOOL | | 手动/自动 | 输入端
| I0.2 | BOOL | | 急停按钮 | 输入端
| I0.3 | BOOL | | 启动按钮 | 输入端
| I0.4 | BOOL | | 停机按钮 | 输入端
| I0.5 | BOOL | | 流量开关 | 输入端
| I0.6 | BOOL | | 液位开关 | 输入端
| I0.7 | BOOL | | 变频器故障 | 输入端
| I1.0 | BOOL | | 罗茨风机过载 | 输入端
| I1.1 | BOOL | | 螺杆过载 | 输入端
| I1.2 | BOOL | | RESERVE | 输入端
| I1.3 | BOOL | | = | 输入端
| I1.4 | BOOL | | = | 输入端
| I1.5 | BOOL | | = | 输入端
| I1.6 | BOOL | | = | 输入端
| I1.7 | BOOL | | = | 输入端
| I2.0 | BOOL | | = | 输入端
| I2.1 | BOOL | | = | 输入端
| PIW0 | WORD | | 真空变送器 | 输入端
| PIW2 | WORD | | 温度变送器 | 输入端
| PIW4 | WORD | | 预留 | 输入端
| PIW6 | WORD | | = | 输入端
| Q0.0 | BOOL | | 报警蜂鸣器 | 输出端

冉昆真空科技（浙江）有限公司 | &EAB

=

页 | 2.a

版权保护。严令禁止在未获得明确授权的情况下转发和复制本文档，利用及传播其内容。

PLC 地址概览 | F48_001
CPU (间接的) | PLC 地址 | 数据类型 | 符号地址(自动) | 功能文本(自动) | 方向 | 规划对象名称
| Q0.1 | BOOL | | 运行指示灯 | 输出端
| Q0.2 | BOOL | | 停机指示灯 | 输出端
| Q0.3 | BOOL | | 螺杆泵 | 输出端
| Q0.4 | BOOL | | 罗茨泵 | 输出端
| Q0.5 | BOOL | | 清洗阀 | 输出端
| Q0.6 | BOOL | | 吹扫阀 | 输出端
| Q0.7 | BOOL | | 入口阀 | 输出端
| Q1.0 | BOOL | | RESERVE | 输出端
| Q1.1 | BOOL | | = | 输出端
| Q1.2 | BOOL | | = | 输出端
| Q1.3 | BOOL | | = | 输出端

X1

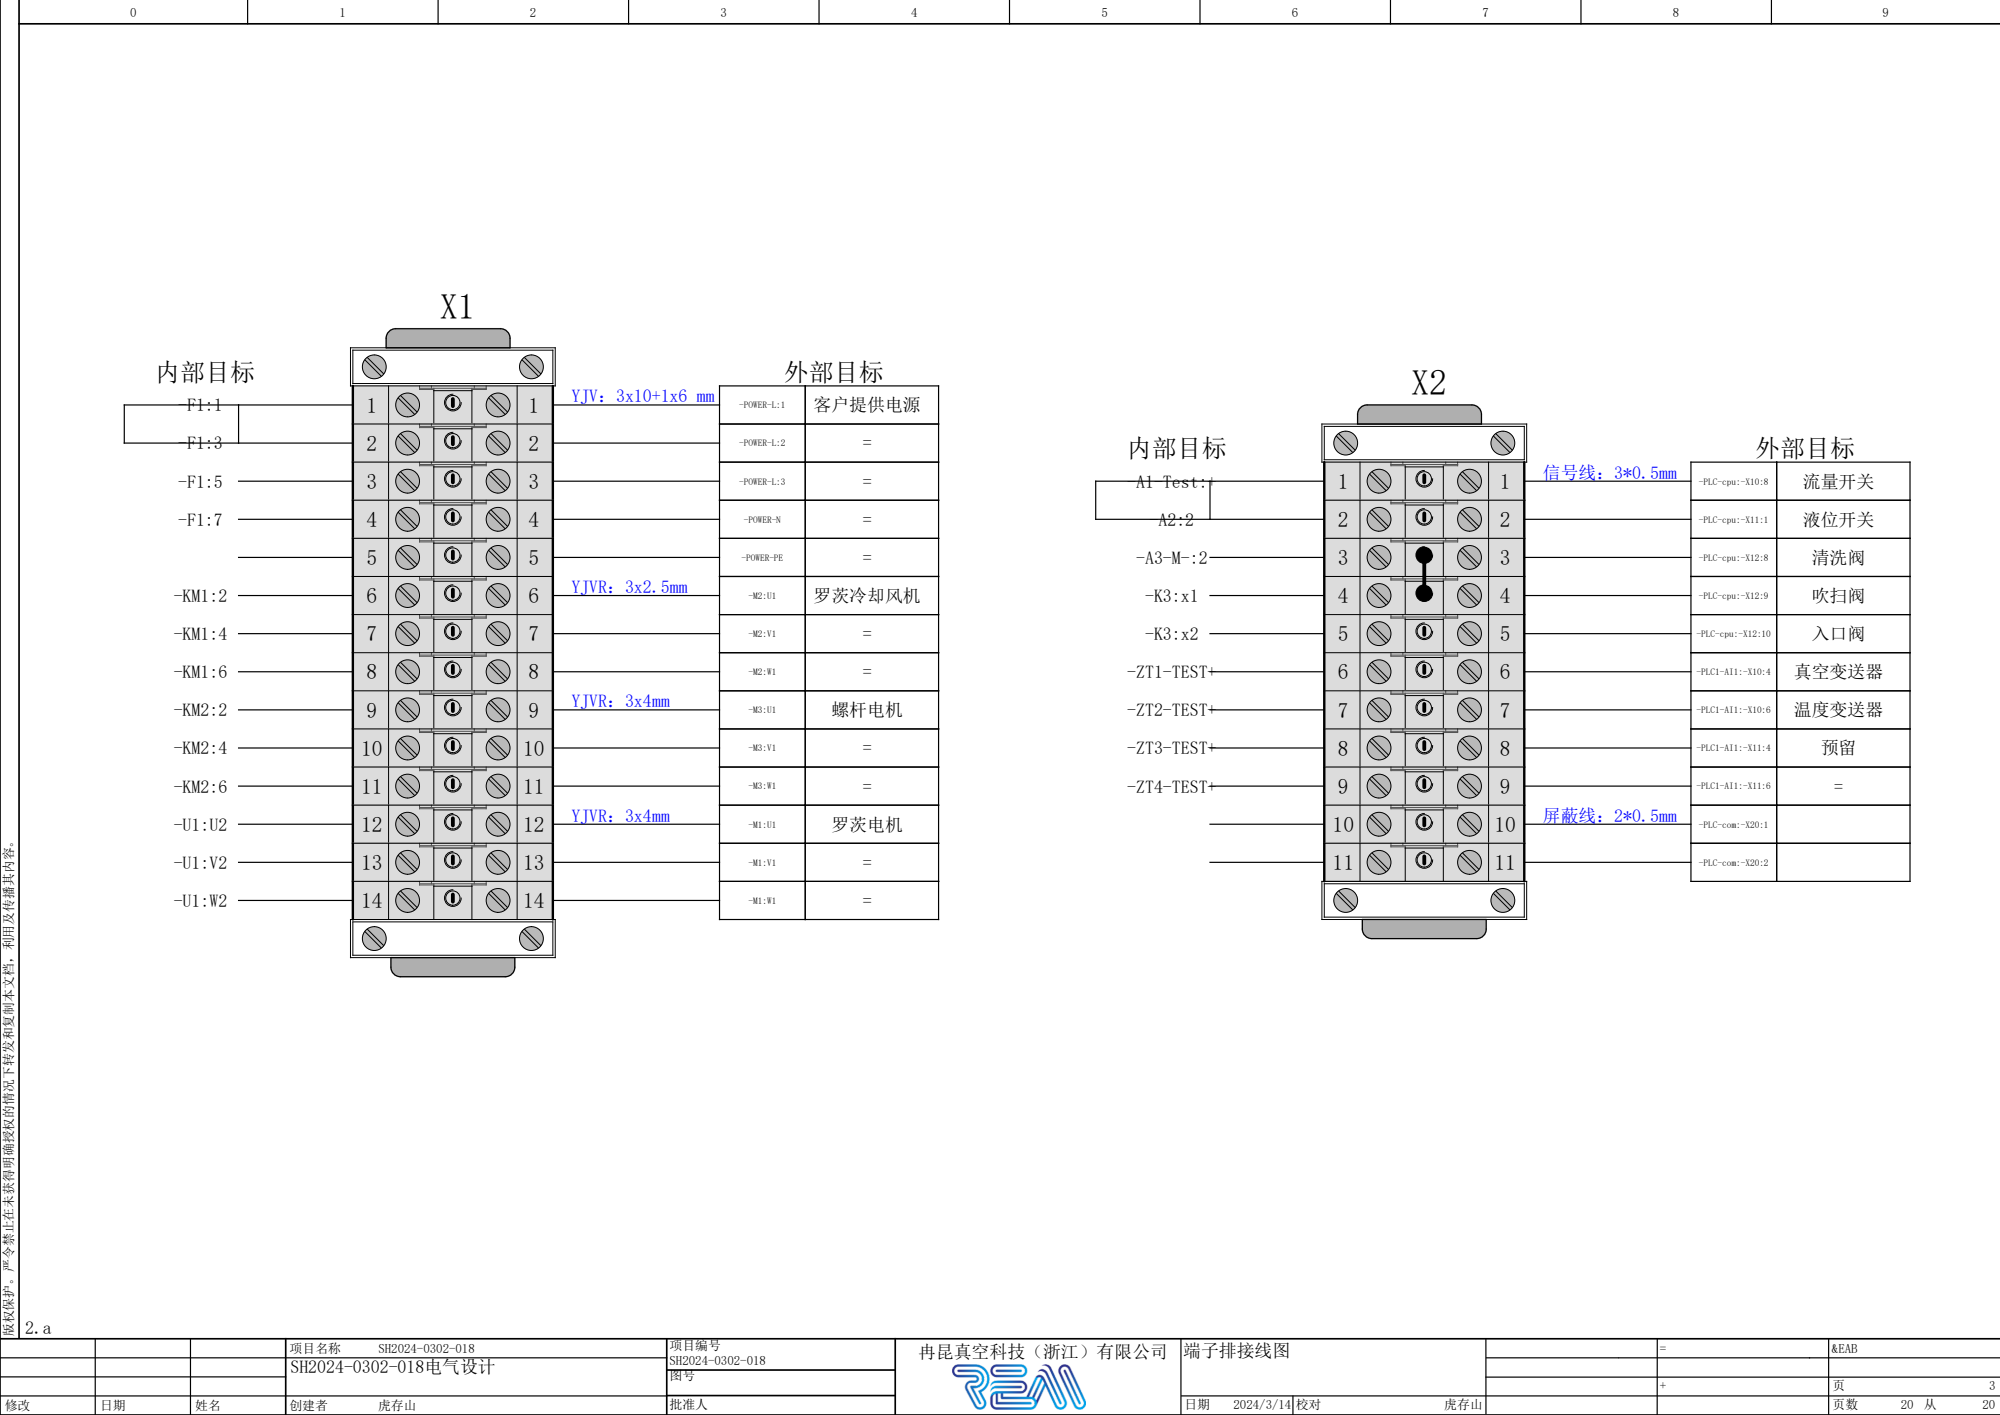
[picture p16: page 20]
冉昆真空科技（浙江）有限公司; &EAB; 端子排接线图; 内部目标; 外部目标; -POWER-L:1; 客户提供电源; -POWER-L:2; -POWER-L:3; -POWER-N; -POWER-PE; 罗茨冷却风机; 螺杆电机; 罗茨电机; -A1-Test:+; -PLC-cpu:-X10:8; 流量开关; -PLC-cpu:-X11:1; 液位开关; -PLC-cpu:-X12:8; 清洗阀; -PLC-cpu:-X12:9; 吹扫阀; -PLC-cpu:-X12:10; 入口阀; -ZT1-TEST+; -PLC1-AI1:-X10:4; 真空变送器; -ZT2-TEST+; -PLC1-AI1:-X10:6; 温度变送器; -ZT3-TEST+; -PLC1-AI1:-X11:4; -ZT4-TEST+; -PLC1-AI1:-X11:6; -PLC-com:-X20:1; -PLC-com:-X20:2; YJV：3x10+1x6 mm; YJVR：3x2.5mm; YJVR：3x4mm; 信号线：3*0.5mm; 屏蔽线：2*0.5mm

版权保护。严令禁止在未获得明确授权的情况下转发和复制本文档，利用及传播其内容。
