HuTongShan/-_-_PLC/(commit log)

2025-05-08 商业项目
2025-05-08 Create PLC_程序
2025-05-08 HMI_程序
2025-05-08 新文件夹
2025-05-08 Create 新文件夹2
2025-05-08 Create 你好
